J-E-J-S/LPA-hardware/README.md

**Work in Progress**

**96 Well Light Plate Apparatus (LPA)**
==============================================

* incorporate cooling solution 
* reduce LEDs per well 2 -> 1 
* increase wells 24 -> 96
