J-E-J-S/LPA-hardware/Tabor_Docs/specifications/index.html

- Docs »
- Specifications
- View page source

# Specifications¶

Warning

The following specifications describe the LPA v1.0. Changes to later LPA versions are described in the releases section of the github repo.

- Electronics
  - Detailed circuit board photographs
  - Circuit board SD-card reader stage schematic
  - Circuit board microcontroller stage schematic
  - Circuit board LED driver stage schematic
  - Circuit board power stage schematic
- Firmware
  - Introduction
  - States of the Firmware Program
  - TLC5941 Driver module
  - MsTimer Module
  - StatusLeds Module
  - SD Card Reading
  - The config.h File
  - firmware.cpp
- Chassis
  - Detailed photographs of 3D printed LPA parts
  - Photographs of LPA gaskets
- Miscellaneous
  - LPA power connections
  - Photographs of 3D printed auxiliary parts
  - Close-up photograph of LED and LED socket friction fit
  - Photograph and schematic of culture plate used in the LPA

Next Previous

© Copyright 2016, Tabor Lab

Built with Sphinx (http://sphinx-doc.org/) using a theme (https://github.com/rtfd/sphinx_rtd_theme) provided by Read the Docs (https://readthedocs.org).
