J-E-J-S/LPA-hardware/Tabor_Docs/specifications/chassis/specifications_chassis.html

- Docs »
- Specifications »
- Chassis
- View page source

# Chassis¶

## Detailed photographs of 3D printed LPA parts¶

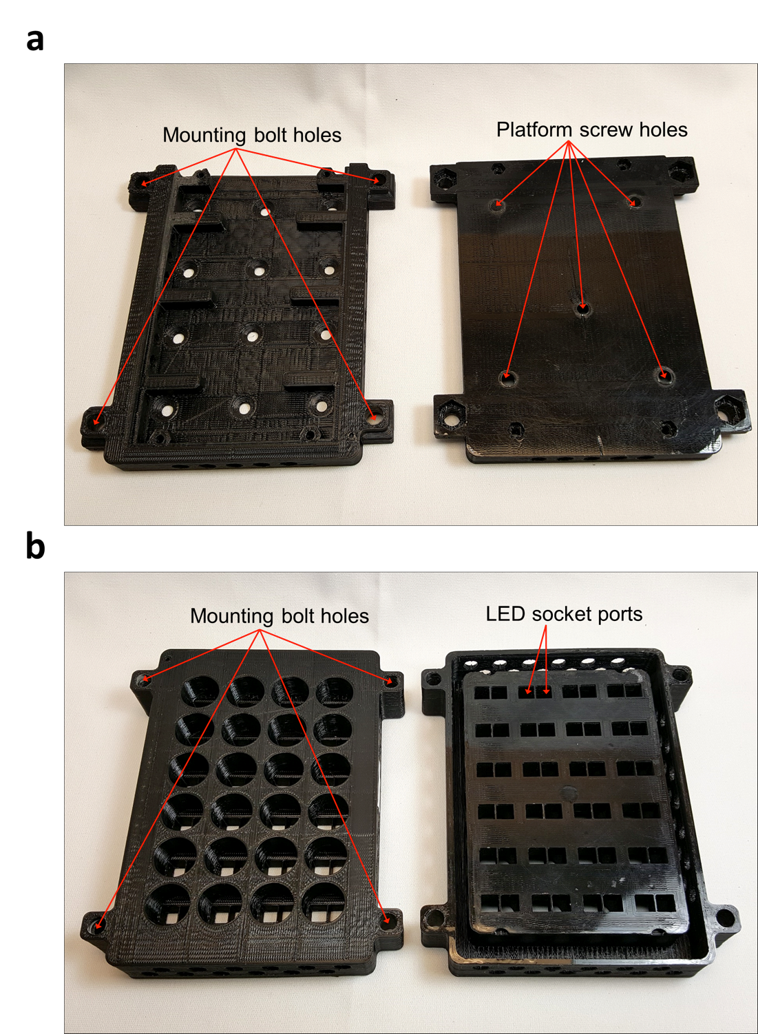
[picture p1: Tabor_Docs/_images/chassis_1.png]


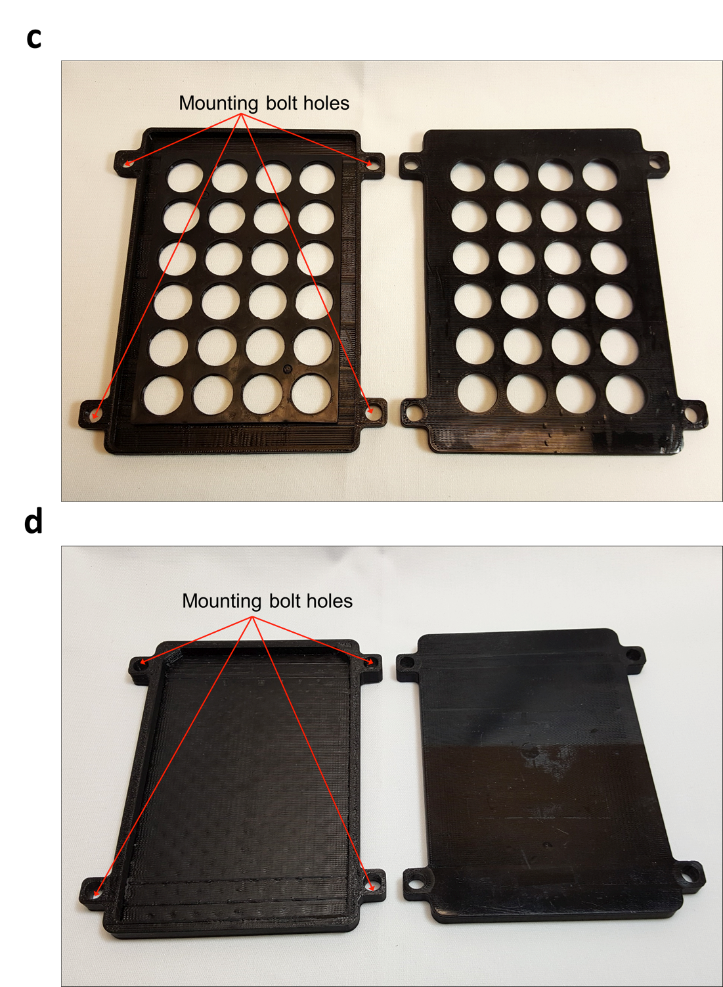
[picture p2: Tabor_Docs/_images/chassis_2.png]


Bottom and top perspectives of 3D printed LPA parts are shown. These include (a) mounting plate, (b) LED spacer, (c) cell culture plate adapter, and (d) device lid. If shaking culture is required, the mounting plate platform holes must be designed for a particular platform. The two mounting plates shown were designed for two different shaking platforms.

## Photographs of LPA gaskets¶



LPA gaskets are laser cut (see Supplementary Method on Laser cutting gaskets) from nitrile sheets (Supplementary Table S6) and prevent light leakage and crosstalk between wells. (a) The (i) circuit board, (ii) LED spacer, and (iii) cell culture plate adapter gaskets are shown. Gasket names are based on the layer they lay atop. Though not necessary, we found it convenient to superglue on the cell culture plate adapter gasket. (b) A plate adapter gasket which has been laser cut with patterns centered with wells of the culture plate.

Next Previous

© Copyright 2016, Tabor Lab

Built with Sphinx (http://sphinx-doc.org/) using a theme (https://github.com/rtfd/sphinx_rtd_theme) provided by Read the Docs (https://readthedocs.org).
