J-E-J-S/LPA-hardware/PCB/output/lpa96_bottom.png

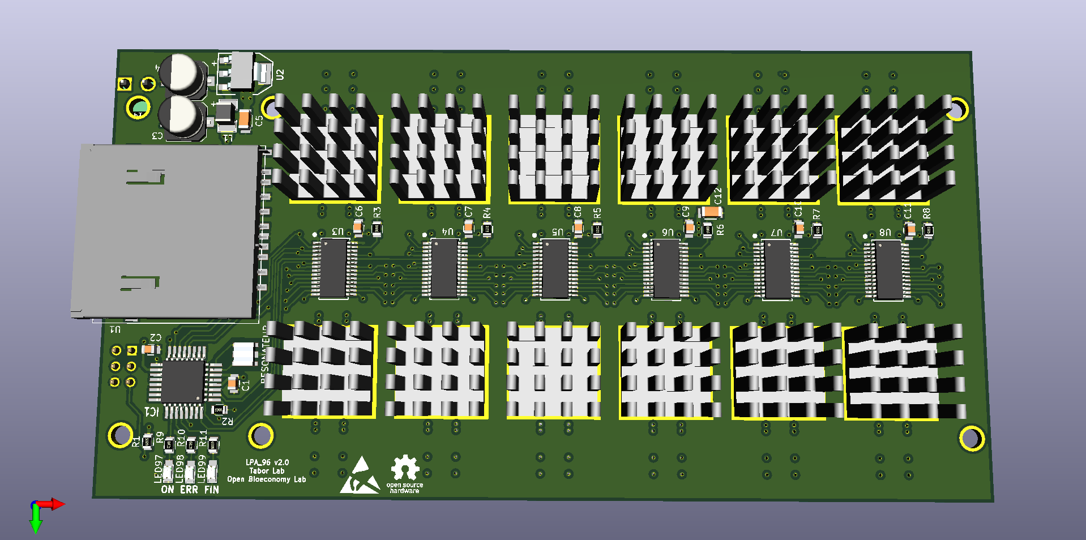
PCB/output/lpa96_bottom.png
