J-E-J-S/LPA-hardware/PCB/output/lpa96_top.png

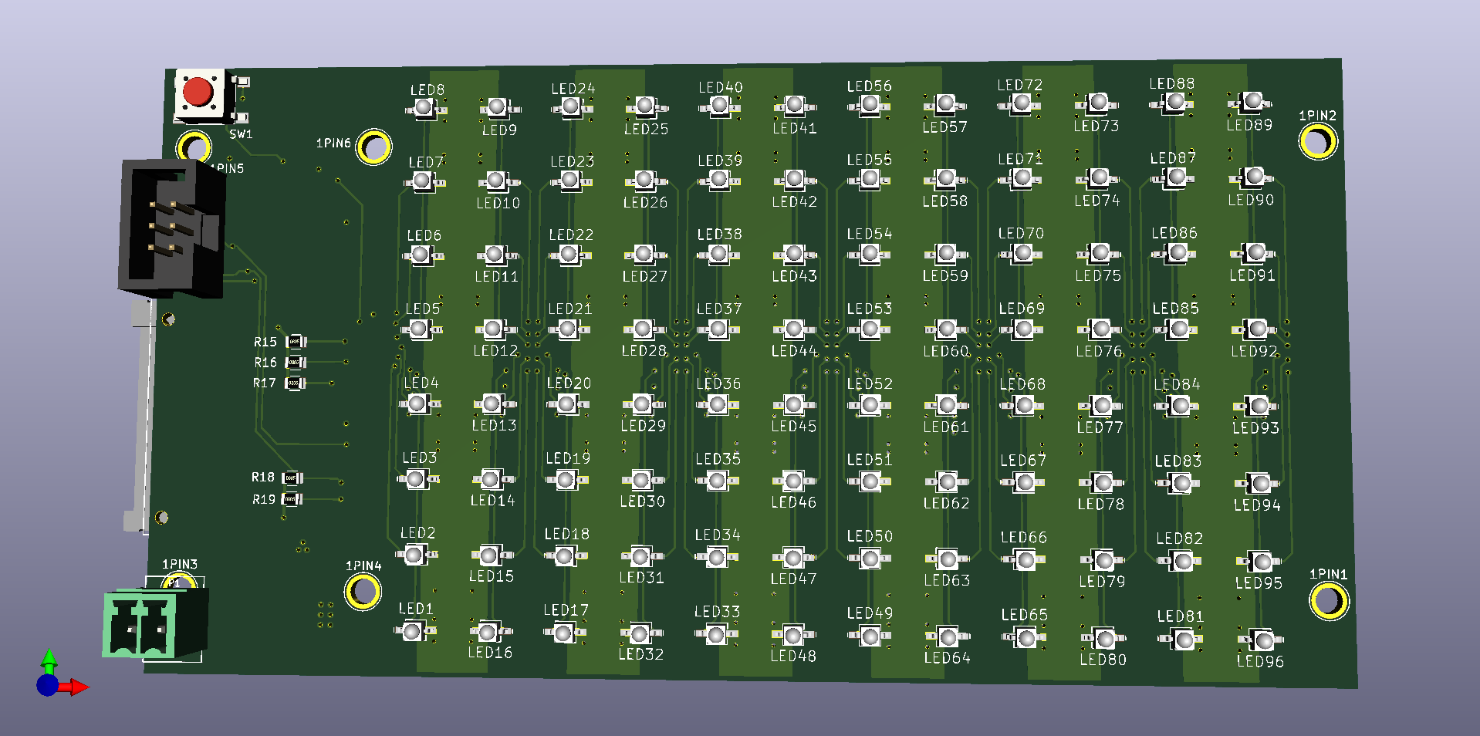
PCB/output/lpa96_top.png
