J-E-J-S/LPA-hardware/Tabor_Docs/_images/firmware_1.png

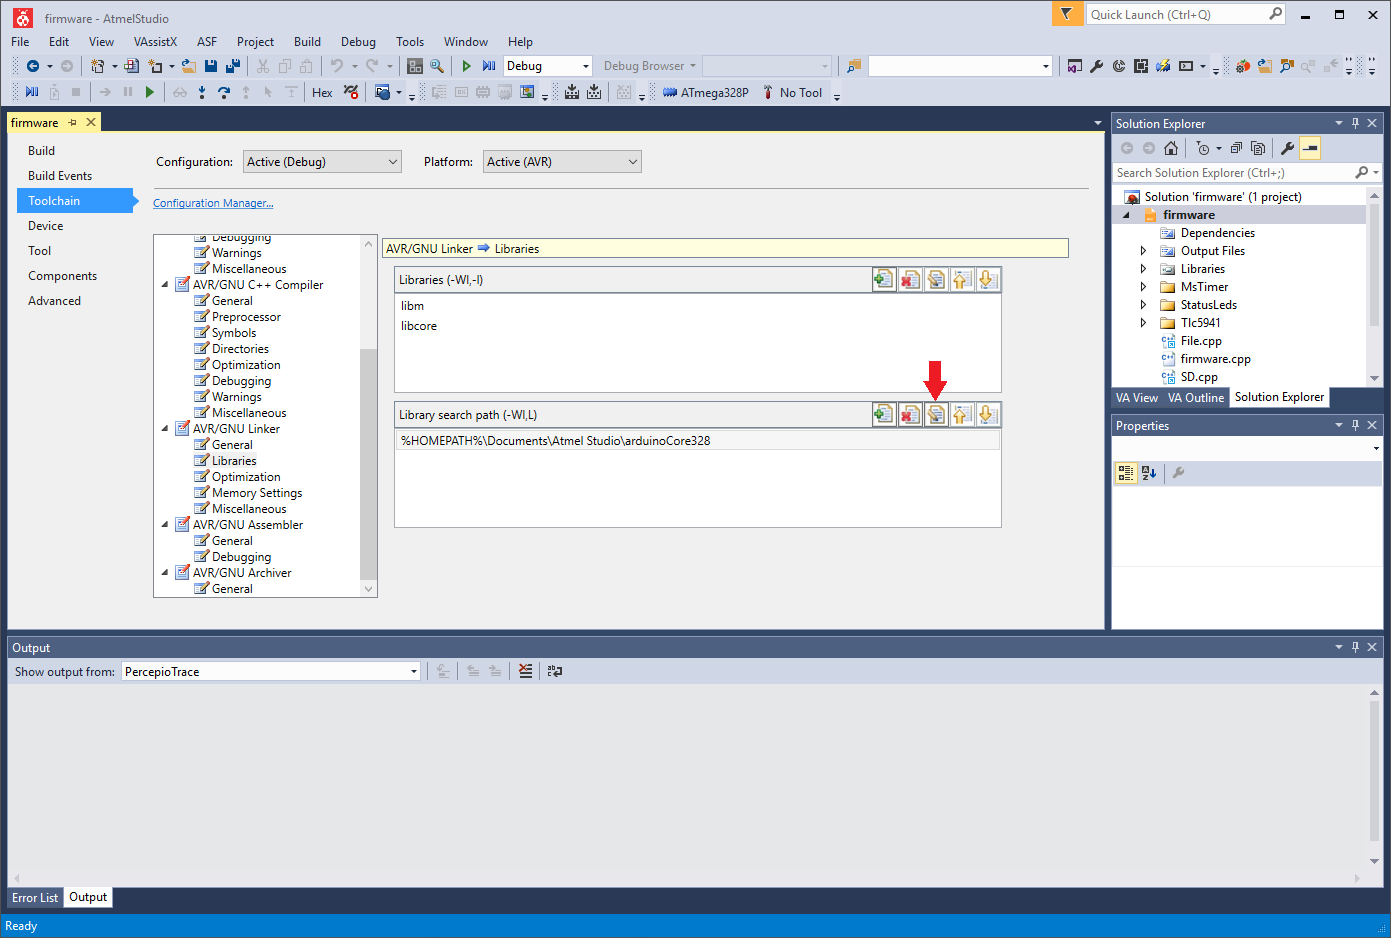
Tabor_Docs/_images/firmware_1.png
