J-E-J-S/LPA-hardware/Tabor_Docs/_images/firmware_2.png

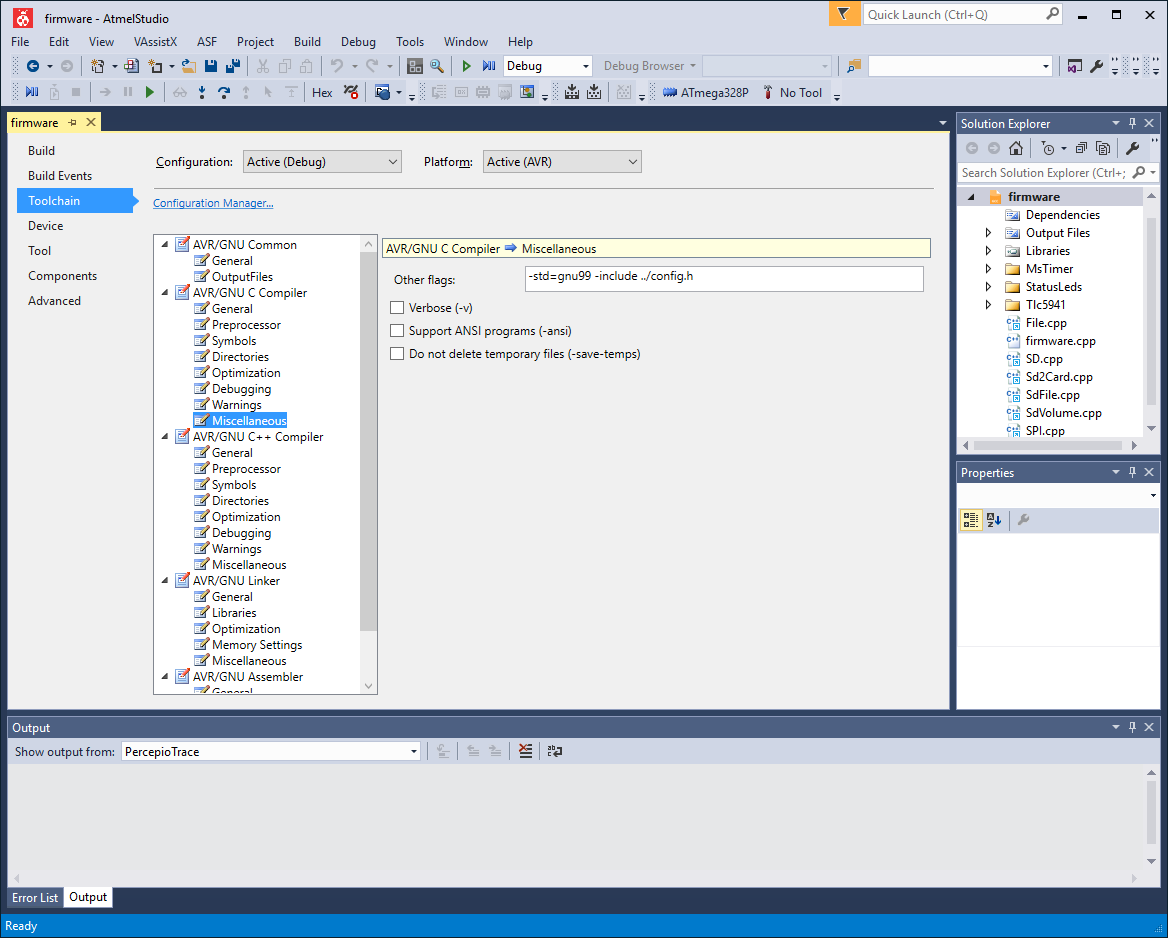
Tabor_Docs/_images/firmware_2.png
