J-E-J-S/LPA-hardware/Tabor_Docs/_images/firmware_4.png

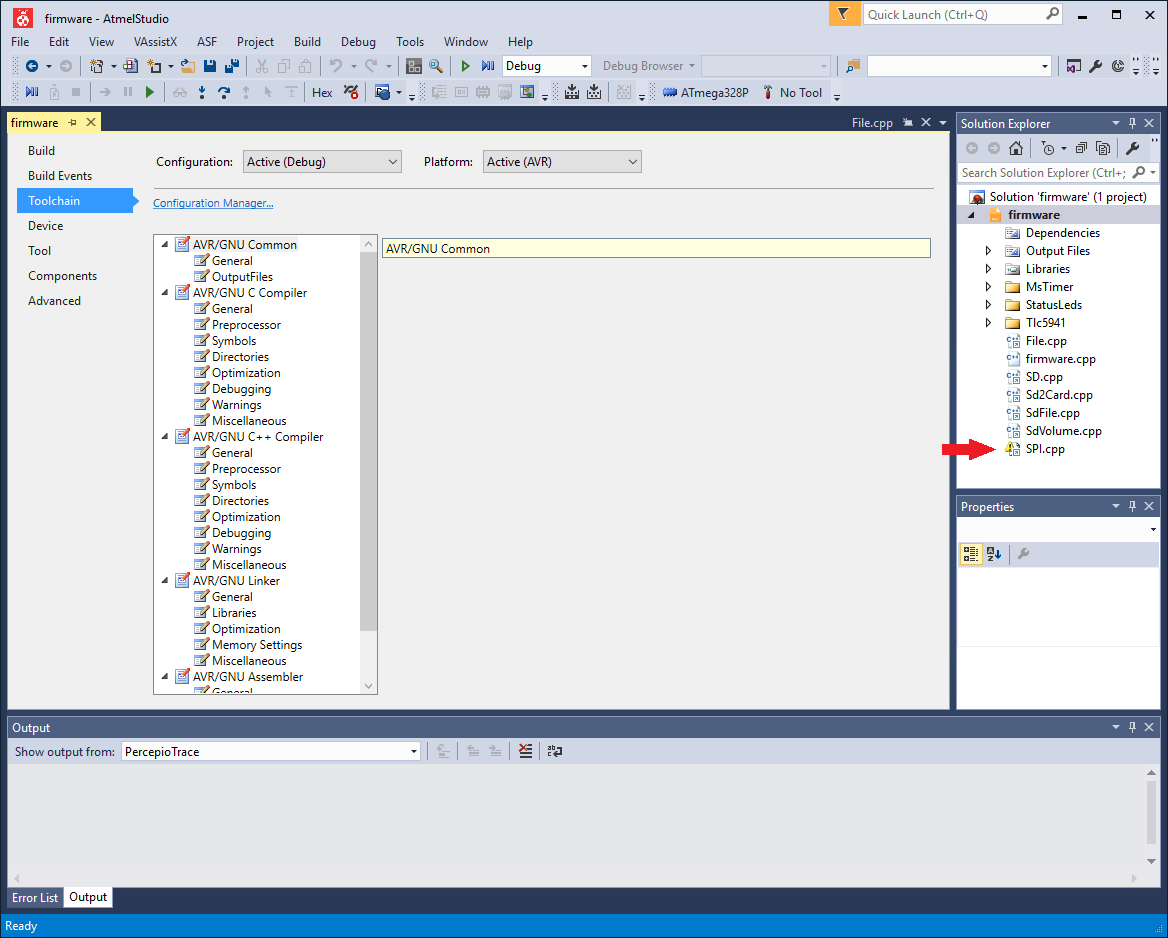
Tabor_Docs/_images/firmware_4.png
