J-E-J-S/LPA-hardware/Tabor_Docs/_images/firmware_6.png

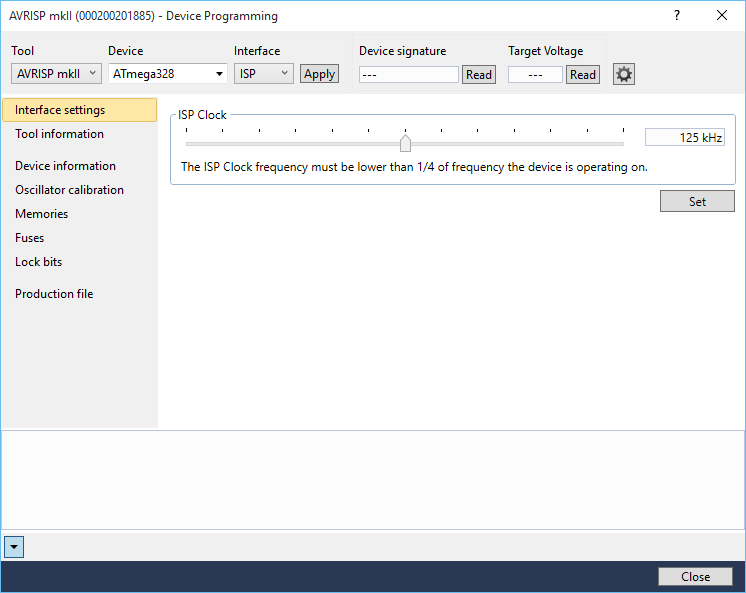
Tabor_Docs/_images/firmware_6.png
