J-E-J-S/LPA-hardware/LPA96_BOM.xlsx

LPA96 v2.0 BOM (incomplete pending source data)
Kevin Bibby 22/08/2019
Item | Qty | Reference(s) | Description | Value | Mfg P/N # | MPN (different) | LibPart | Footprint | Datasheet
1 | 8 | C1, C2, C6, C7, C8, C9, C10, C11 | CAP CER 0.1UF 50V Y5V 0805 | 100nF | CL21F104ZBCNNNC |  | Device:C | Capacitors_SMD:C_0805 | ~
2 | 2 | C3, C4 | 47 uF electrolytic SMD | 47uF | 493-2202-1-ND |  | Device:C | lpa96_footprints:CP_Elec_6.3x5.3 | ~
3 | 2 | C5, C12 | CAP CER 10UF 25V X5R 1206 | 10uF | CL31A106KAHNNNE | C1206C106K3PACTU | Device:C | Capacitors_SMD:C_1206 | ~
4 | 1 | IC1 | IC MCU 8BIT 32KB FLASH 32TQFP | ATMEGA328-A | ATMEGA328-AU |  | lpa96_symbols:ATMEGA328-A | lpa96_footprints:TQFP32_FIXED
5 | 1 | L1 | 10 uH inductor SMD | 10uH | 399-9595-1-ND | CBC3225T100MR | Device:L | lpa96_footprints:L-1210 | ~
6 | 96 | LED1, LED2, LED3, LED4, LED5, LED6, LED7, LED8, LED9, LED10, LED11, LED12, LED13, LED14, LED15, LED16, LED17, LED18, LED19, LED20, LED21, LED22, LED23, LED24, LED25, LED26, LED27, LED28, LED29, LED30, LED31, LED32, LED33, LED34, LED35, LED36, LED37, LED38, LED39, LED40, LED41, LED42, LED43, LED44, LED45, LED46, LED47, LED48, LED49, LED50, LED51, LED52, LED53, LED54, LED55, LED56, LED57, LED58, LED59, LED60, LED61, LED62, LED63, LED64, LED65, LED66, LED67, LED68, LED69, LED70, LED71, LED72, LED73, LED74, LED75, LED76, LED77, LED78, LED79, LED80, LED81, LED82, LED83, LED84, LED85, LED86, LED87, LED88, LED89, LED90, LED91, LED92, LED93, LED94, LED95, LED96 |  | LED_ALT |  |  | Device:LED_ALT | lpa96_footprints:VLDx1232G | ~
7 | 3 | LED97, LED98, LED99 | SMD LED Green / SMD LED Red / SMD LED YELLOW | LED_ALT | 475-1410-1-ND / 475-1415-1-ND / 475-2560-1-ND |  | Device:LED_ALT | LEDs:LED_0805 | ~
8 | 1 | P1 |  | CONN_2 |  |  | lpa96_symbols:CONN_2 | lpa96_footprints:PIN_ARRAY_2X1_3960um
9 | 1 | P2 |  | CONN_3X2 |  |  | lpa96_symbols:CONN_3X2 | lpa96_footprints:pin_array_3x2
10 | 2 | R1, R2 | RES SMD 10K OHM 5% 1/8W 0805 | 10K | ERJ-6GEYJ103V |  | Device:R | Resistors_SMD:R_0805 | ~
11 | 6 | R3, R4, R5, R6, R7, R8 | RES SMD 2.2K OHM 0.5% 1/10W 0805 | 2.2K | RR1220P-222-D |  | Device:R | Resistors_SMD:R_0805 | ~
12 | 3 | R9, R10, R11 | RES SMD 330 OHM 5% 1/8W 0805 | 330 | RC2012J331CS | CRGCQ0805J330R | Device:R | Resistors_SMD:R_0805 | ~
13 | 5 | R15, R16, R17, R18, R19 | 50k resistor (0805) | 50k | P47KACT-ND |  | Device:R | Resistors_SMD:R_0805 | ~
14 | 1 | SW1 | SWITCH TACTILE SPST-NO 0.05A 12V | SW_PUSH | PTS645SK43SMTR92 LFS |  | lpa96_symbols:SW_PUSH | lpa96_footprints:SW_PUSH_SMD | ~
15 | 1 | U1 | CONN SD CARD PUSH-PUSH R/A SMD | SD_CARD | 101-00313-68-02 | 67600-8001 | lpa96_symbols:SD_CARD | lpa96_footprints:SD_CONN
16 | 1 | U2 | LDO Voltage Regulators | LD1117S33 | LD1117S34 |  | lpa96_symbols:LD1117S50 | lpa96_footprints:SOT223 | ~
17 | 6 | U3, U4, U5, U6, U7, U8 | LED Driver IC 16 Output Linear Shift Register 80mA 28-HTSSOP | TLC5941 | TLC5941PWP |  | lpa96_symbols:TLC5941 | lpa96_footprints:TLC5941_PWP_28 | DOCUMENTATION
18 | 1 | Y1 | CRYSTAL 16.0000MHZ 10PF SMD | RESONATEUR | 403C11A16M00000 |  | lpa96_symbols:RESONATEUR | lpa96_footprints:crystal_smd
 |  |  | Breakaway headers (40 pos, 0.100") |  | A34253-40-ND
 |  |  | Molex connector crimp terminal |  | WM18820CT-ND
 |  |  | Molex 2x1 male connector high- power |  | WM18823-ND
 |  |  | Molex 2x1 female connector |  | WM18813-ND
