J-E-J-S/LPA-hardware/3D_files/Assembly/Assembled.stl

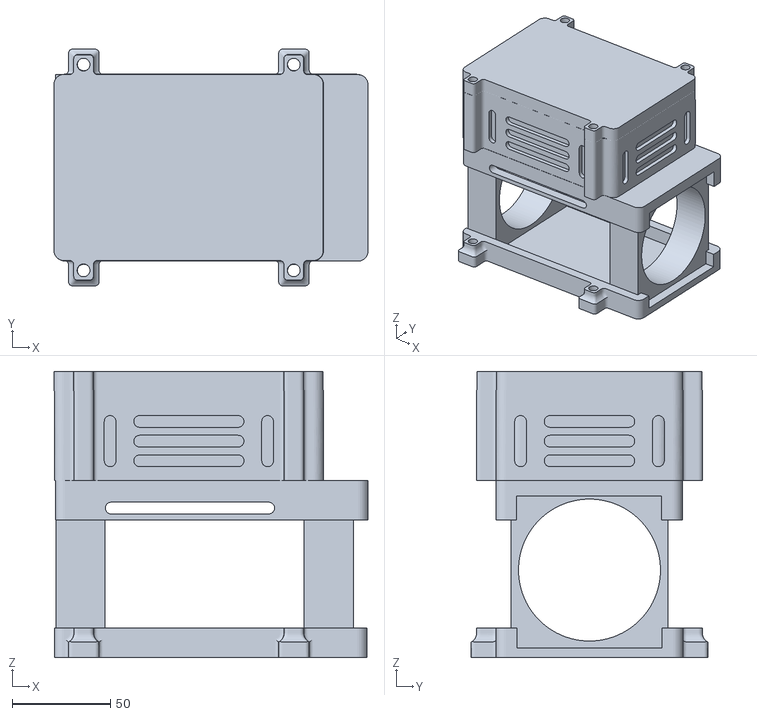
[picture p19: CAD file, 2020-01-30]
3D_files/Assembly/Assembled.stl
159.5 x 120.2 x 145.5
