J-E-J-S/LPA-hardware/3D_files/Assembly/Assembled_Exploded.stl

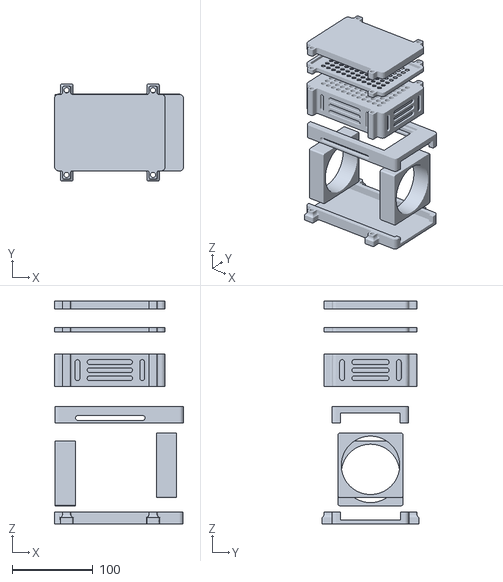
[picture p20: CAD file, 2020-01-30]
3D_files/Assembly/Assembled_Exploded.stl
159.4 x 120.2 x 275.5
