J-E-J-S/LPA-hardware/3D_files/Base_96/Base_96.stl

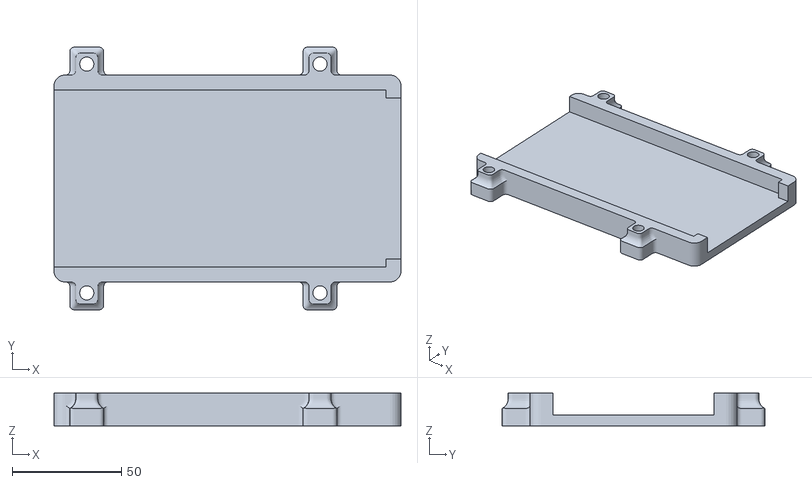
[picture p21: CAD file, 2020-01-29]
3D_files/Base_96/Base_96.stl
158.8 x 120.2 x 15.0
