J-E-J-S/LPA-hardware/3D_files/Gaskets/LED_spacer_gasket/LEDSpacer_Gasket.dxf

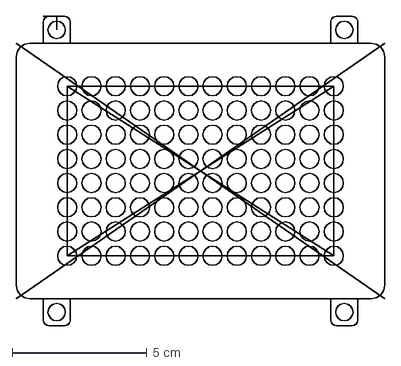
[picture p22: CAD file, 2020-01-29]
3D_files/Gaskets/LED_spacer_gasket/LEDSpacer_Gasket.dxf
13.7 x 11.5 cm
