J-E-J-S/LPA-hardware/3D_files/Gaskets/PCB_gasket/PCB_Gasket.dxf

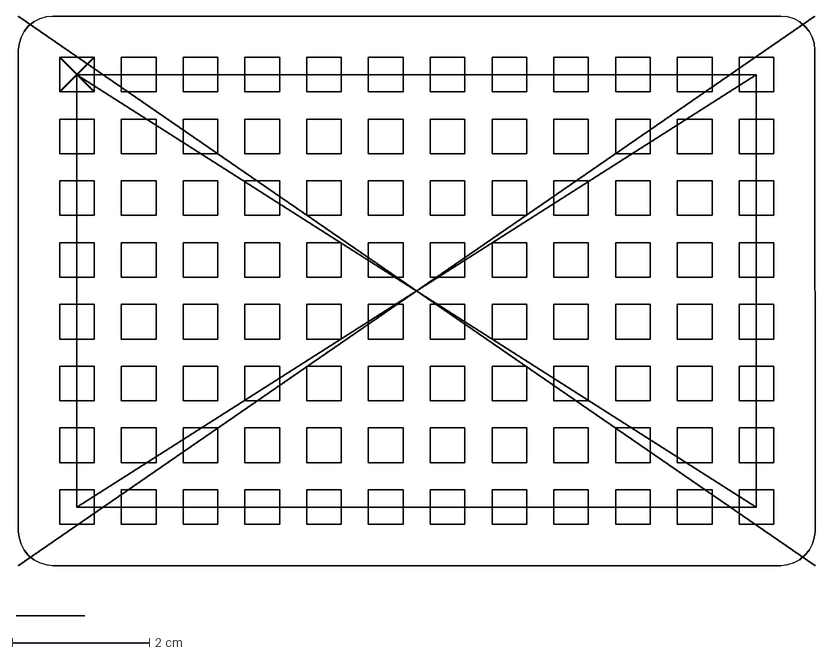
[picture p23: CAD file, 2020-01-29]
3D_files/Gaskets/PCB_gasket/PCB_Gasket.dxf
11.6 x 8.74 cm
