J-E-J-S/LPA-hardware/3D_files/Gaskets/plate_adaptor_gasket/PlateAdaptor_gasket.dxf

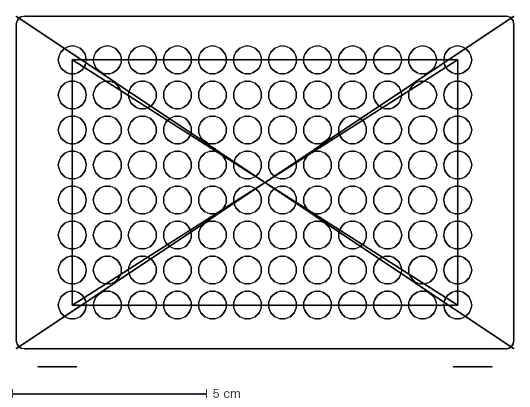
[picture p24: CAD file, 2020-01-29]
3D_files/Gaskets/plate_adaptor_gasket/PlateAdaptor_gasket.dxf
12.8 x 9.01 cm
