J-E-J-S/LPA-hardware/3D_files/LED_Spacer_96/LED_Spacer_96.stl

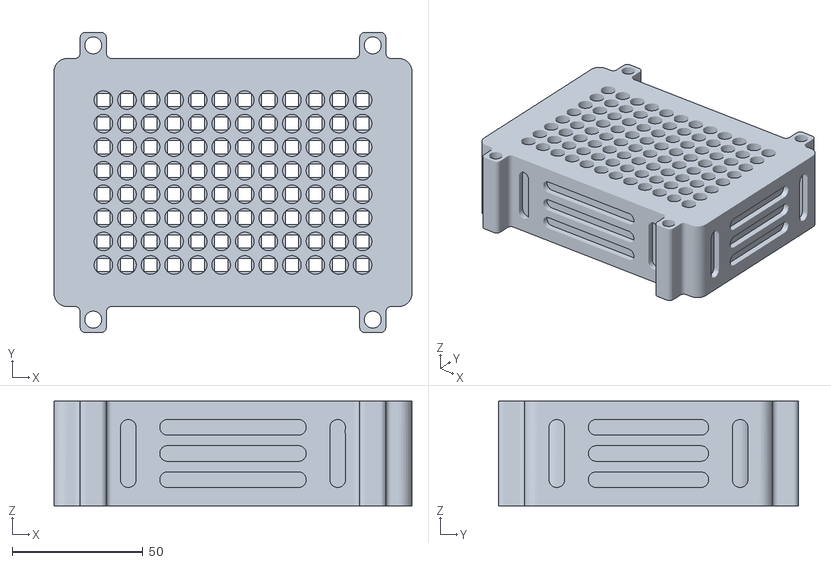
[picture p25: CAD file, 2020-01-29]
3D_files/LED_Spacer_96/LED_Spacer_96.stl
136.8 x 114.7 x 40.0
