J-E-J-S/LPA-hardware/3D_files/Plate_Adaptor_96/Plate_Adaptor_96.stl

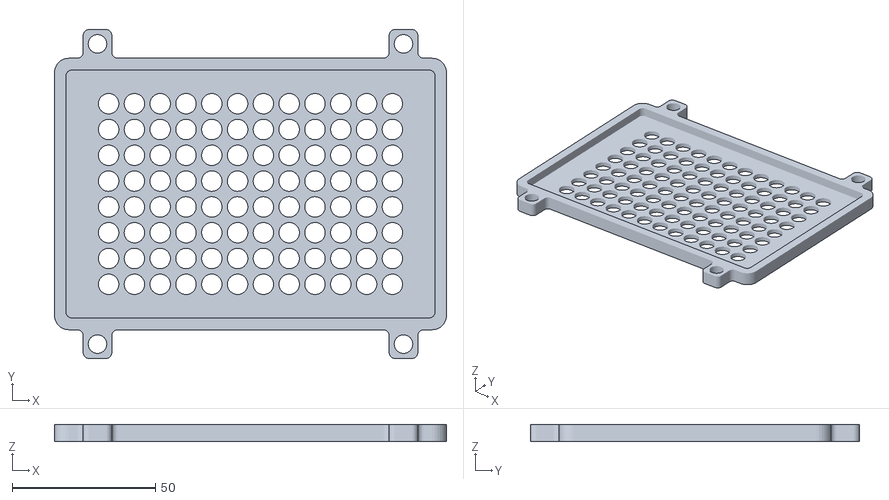
[picture p26: CAD file, 2020-01-29]
3D_files/Plate_Adaptor_96/Plate_Adaptor_96.stl
136.8 x 114.7 x 6.00
