J-E-J-S/LPA-hardware/3D_files/Plate_Lid_96/Plate_Lid_96.stl

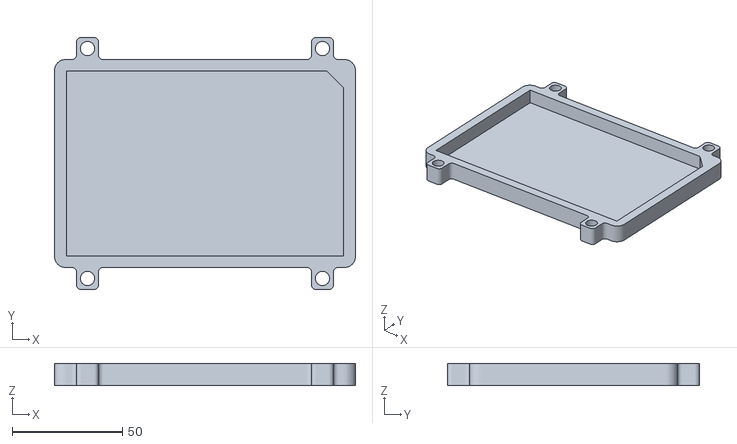
[picture p27: CAD file, 2020-01-29]
3D_files/Plate_Lid_96/Plate_Lid_96.stl
136.8 x 114.5 x 10.0
