J-E-J-S/LPA-hardware/PCB/footprints/3d-models/smd_led_VLDx1535G.step

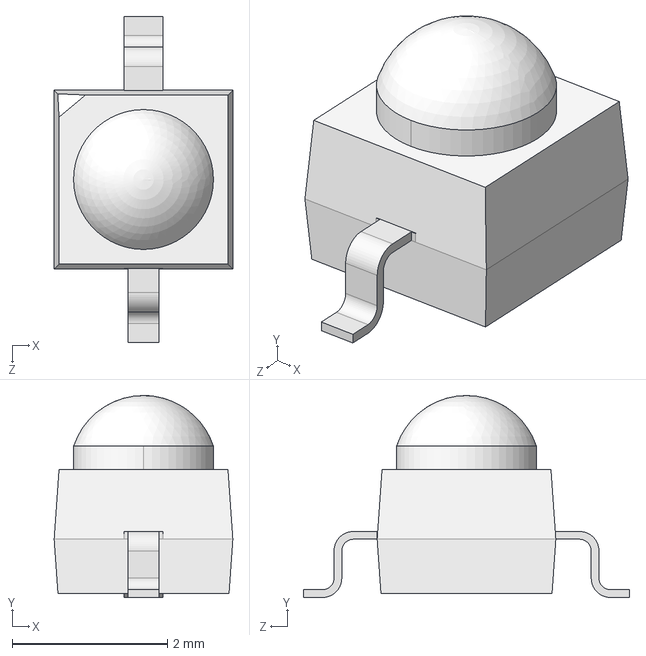
[picture p28: CAD file, 2020-01-29]
PCB/footprints/3d-models/smd_led_VLDx1535G.step
2.30 x 2.60 x 4.20 mm
