J-E-J-S/LPA-hardware/3D_files/Mounting_Plate_96/Mounting_Plate_96.stl

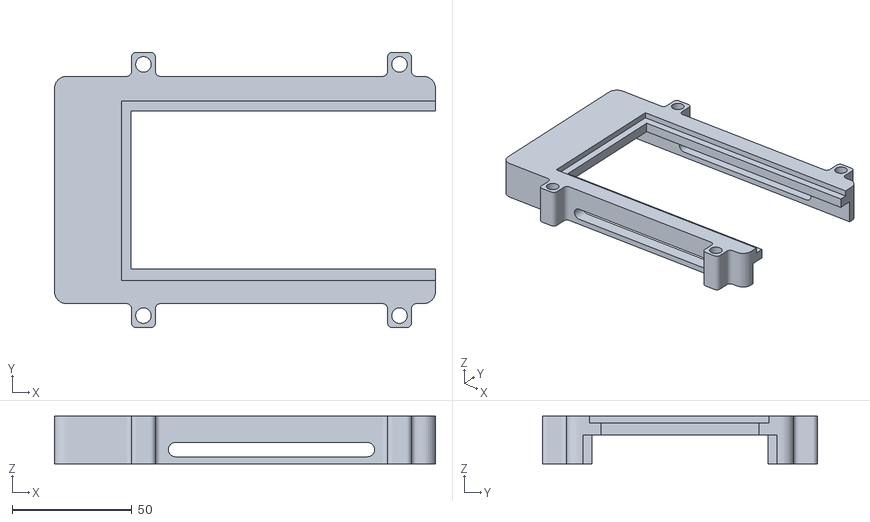
[picture p29: CAD file, 2020-01-29]
3D_files/Mounting_Plate_96/Mounting_Plate_96.stl
158.8 x 114.7 x 20.0
