J-E-J-S/LPA-hardware/PCB/footprints/3d-models/example_resonator.step

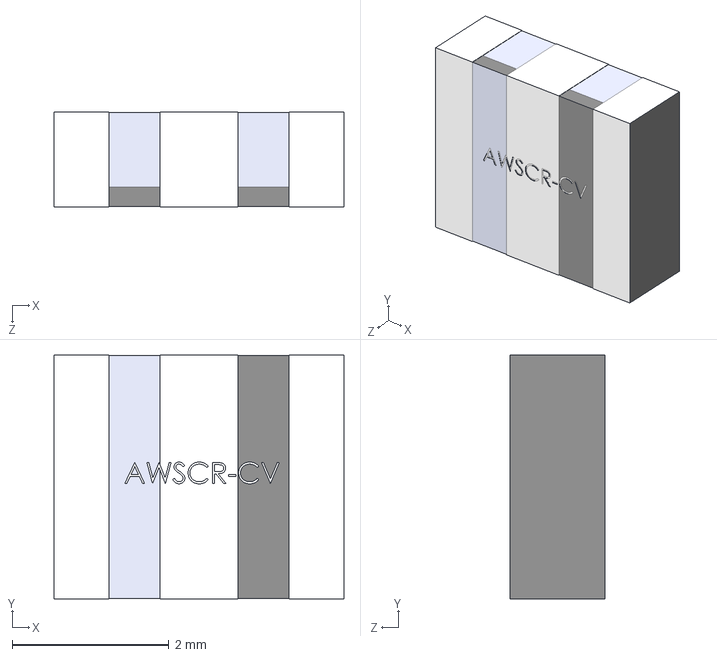
[picture p30: CAD file, 2020-01-29]
PCB/footprints/3d-models/example_resonator.step
3.70 x 3.11 x 1.21 mm
