J-E-J-S/LPA-hardware/PCB/footprints/3d-models/example_heatsink_14x14x14mm.stp

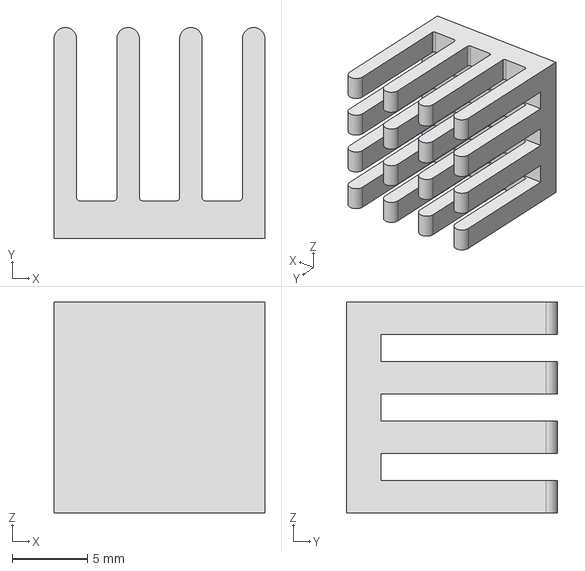
[picture p31: CAD file, 2020-01-29]
PCB/footprints/3d-models/example_heatsink_14x14x14mm.stp
14.0 x 14.0 x 14.0 mm
