J-E-J-S/LPA-hardware/PCB/footprints/3d-models/SD_card_reader_10067847-001RLF.step

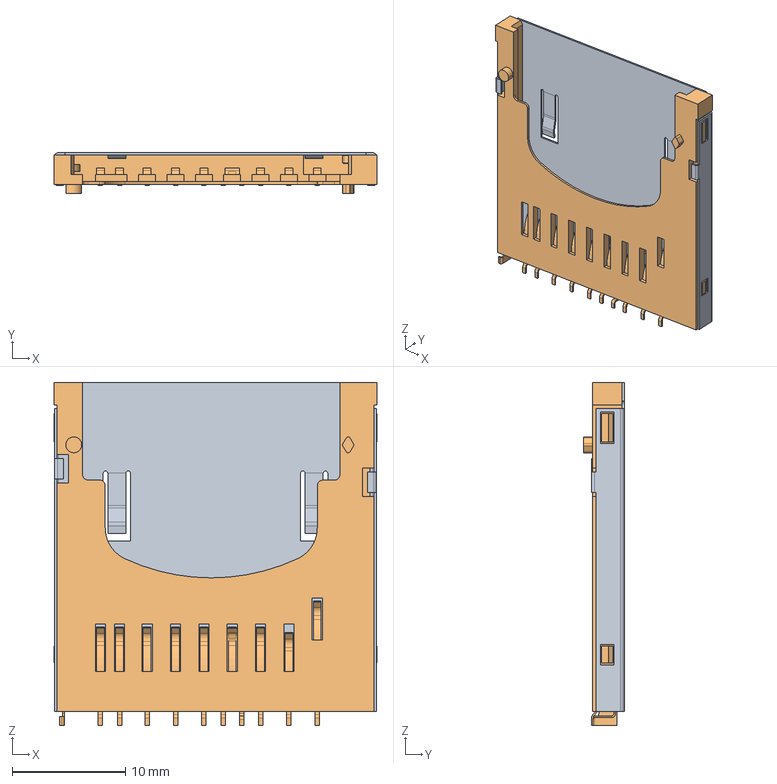
[picture p32: CAD file, 2020-01-29]
PCB/footprints/3d-models/SD_card_reader_10067847-001RLF.step
28.4 x 3.60 x 30.3 mm
PRT0003
PRT0005
