J-E-J-S/LPA-hardware/3D_files/Mounting_Plate_96/Mounting_Plate_96_NoBoltHoles.stl

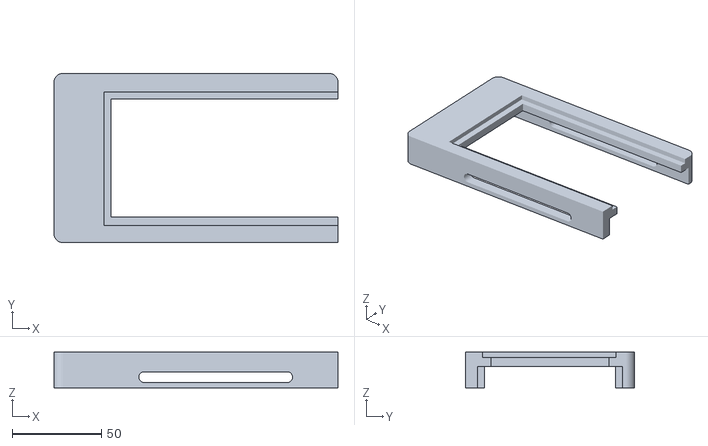
[picture p33: CAD file, 2020-01-29]
3D_files/Mounting_Plate_96/Mounting_Plate_96_NoBoltHoles.stl
158.8 x 94.7 x 20.0
