J-E-J-S/LPA-hardware/(list of files, cad)

Other CAD files:
3D_files/Assembly/Assembled.f3z
3D_files/Assembly/Assembled_Exploded.f3z
3D_files/Base_96/Base_96.f3d
3D_files/Gaskets/LED_spacer_gasket/LEDSpacer_Gasket.f3d
3D_files/Gaskets/PCB_gasket/PCB_Gasket.f3d
3D_files/Gaskets/plate_adaptor_gasket/PlateAdaptor_gasket.f3d
3D_files/LED_Spacer_96/LED_Spacer_96.f3d
3D_files/Mounting_Plate_96/Mounting_Plate_96.f3d
3D_files/Mounting_Plate_96/Mounting_Plate_96_NoBoltHoles.f3d
3D_files/Plate_Adaptor_96/Plate_Adaptor_96.f3d
3D_files/Plate_Lid_96/Plate_Lid_96.f3d
