J-E-J-S/LPA-hardware/Calibration/example/arya_678nm_bot_150802/round1.tif

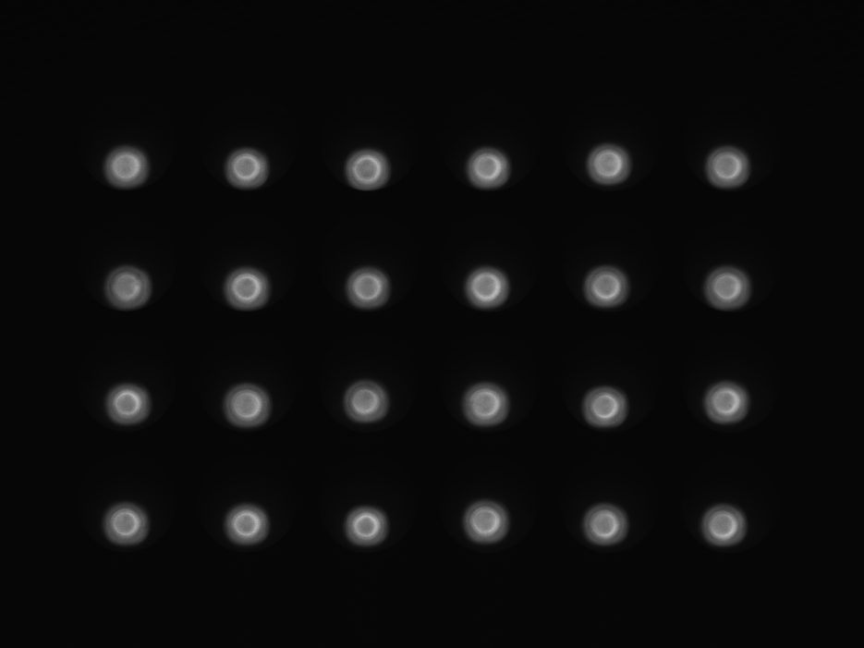
Calibration/example/arya_678nm_bot_150802/round1.tif
