J-E-J-S/LPA-hardware/Calibration/example/arya_678nm_bot_150802/round2.tif

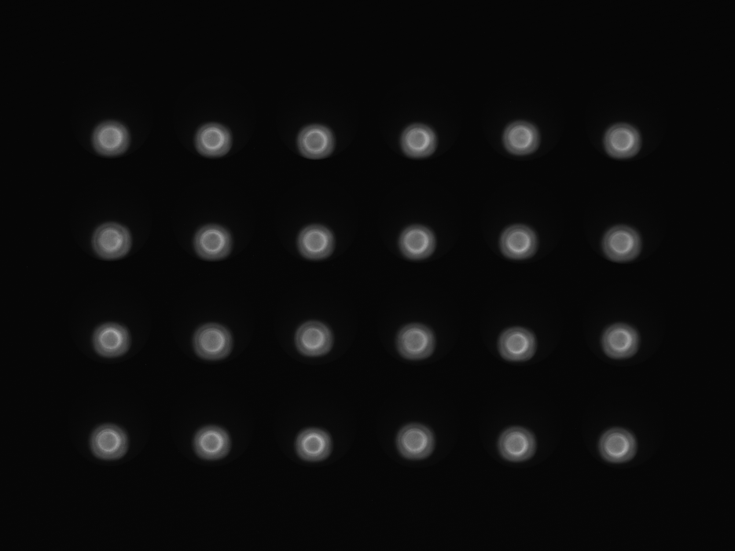
Calibration/example/arya_678nm_bot_150802/round2.tif
