J-E-J-S/LPA-hardware/PCB/output/lpa96_schematic.pdf

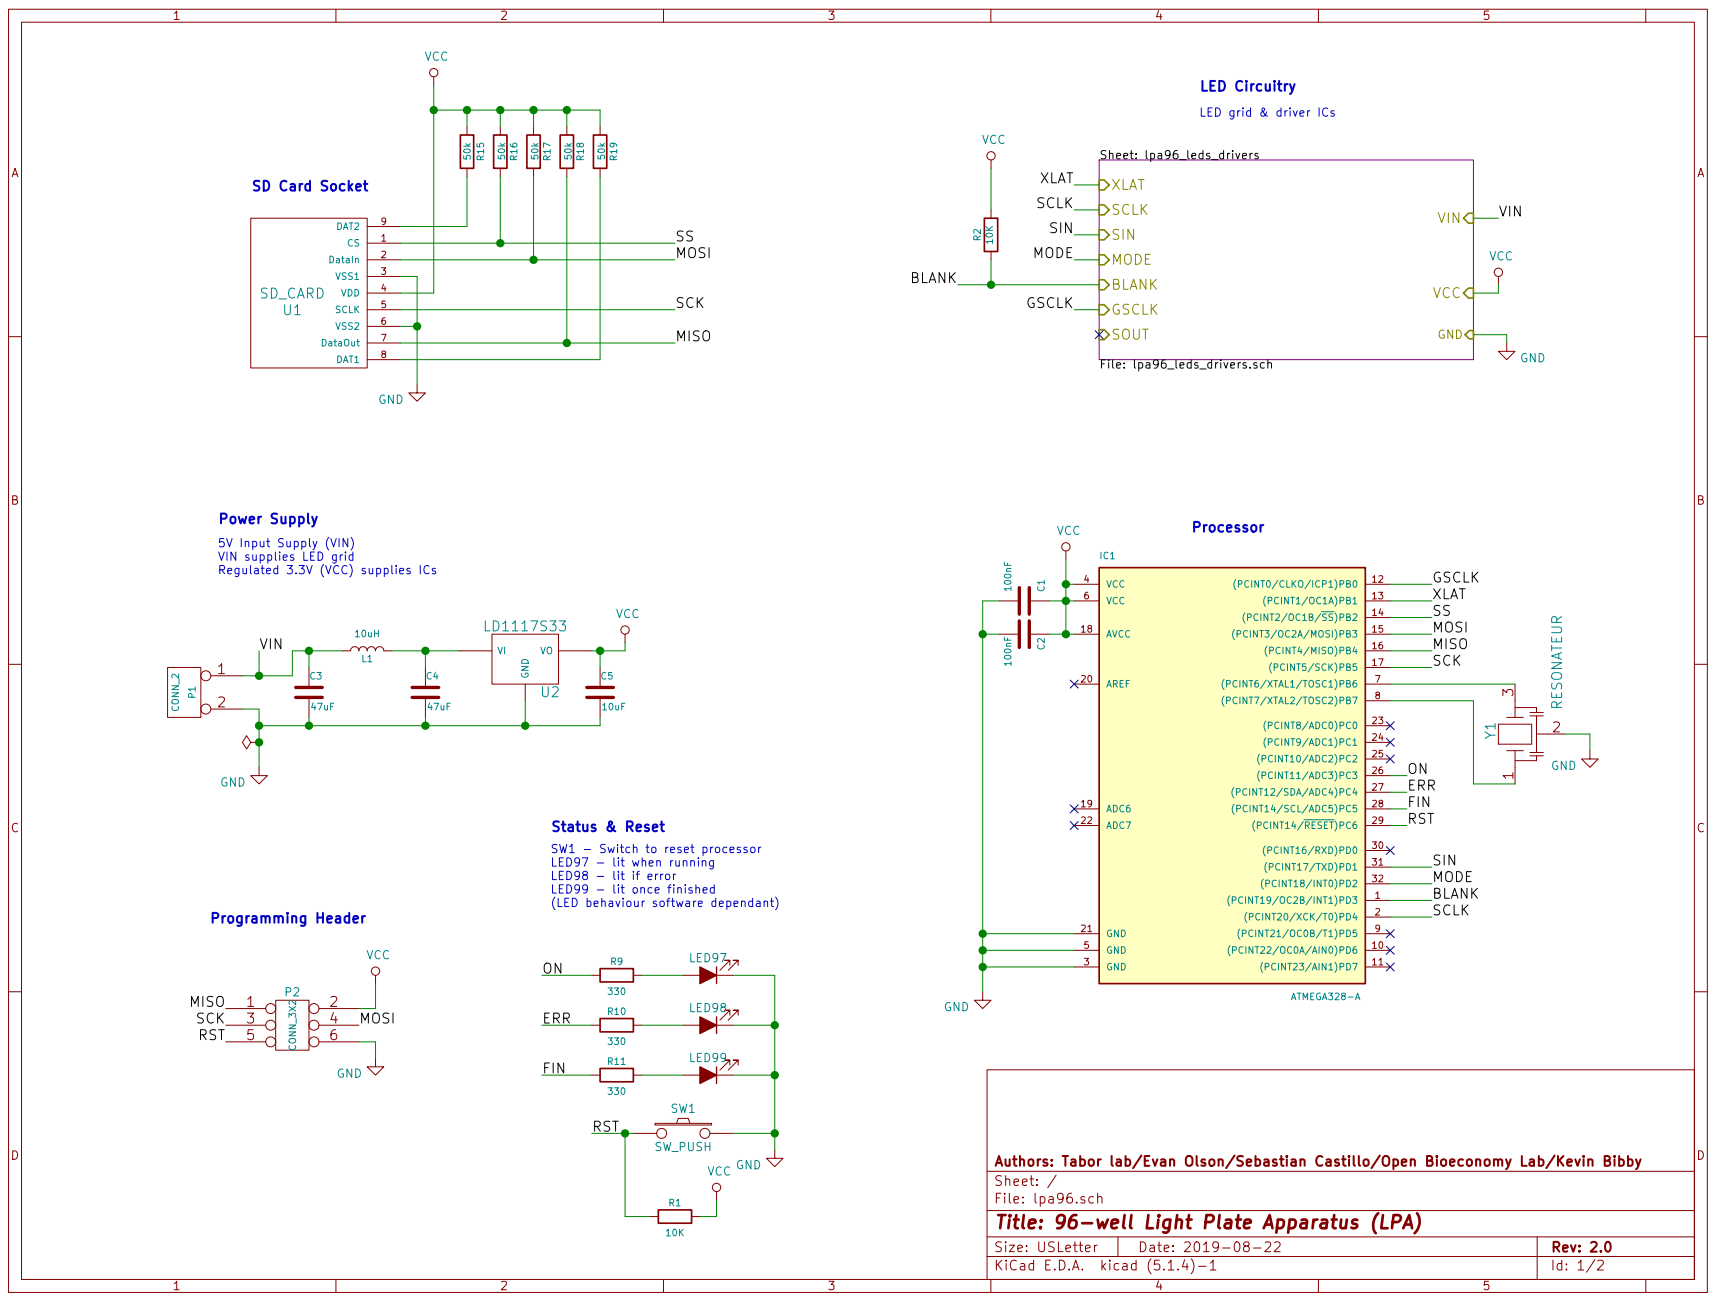
[picture p41: page 1]

LED grid & driver ICs Processor SW1 - Switch to reset processor

File: lpa96_leds_drivers.sch XLAT SCLK

5V Input Supply (VIN)
VIN supplies LED grid

LED97 - lit when running
LED98 - lit if error LED99 - lit once finished

(LED behaviour software dependant)

File: lpa96.sch Sheet: / Authors: Tabor lab/Evan Olson/Sebastian Castillo/Open Bioeconomy Lab/Kevin Bibby

Id: 1/2 Title: 96-well Light Plate Apparatus (LPA)

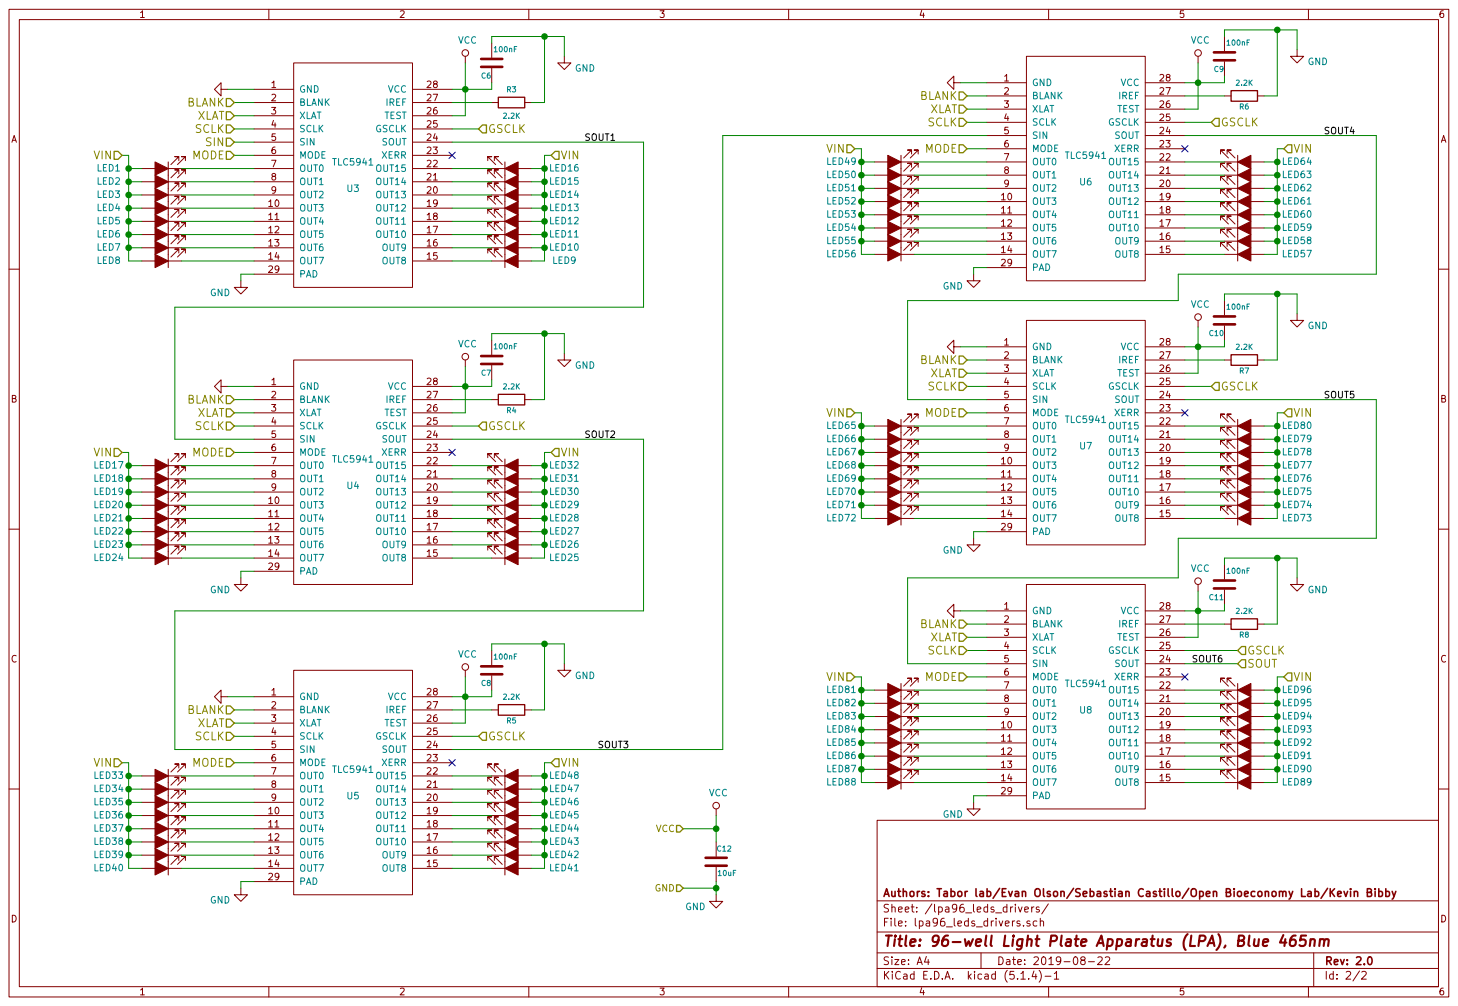
[picture p42: page 2]

Authors: Tabor lab/Evan Olson/Sebastian Castillo/Open Bioeconomy Lab/Kevin Bibby
Sheet: /lpa96_leds_drivers/
File: lpa96_leds_drivers.sch
Id: 2/2 Title: 96-well Light Plate Apparatus (LPA), Blue 465nm
