J-E-J-S/LPA-hardware/PCB/lpa96.kicad_pcb

## KiCad design PCB/lpa96.kicad_pcb (2020-01-29)

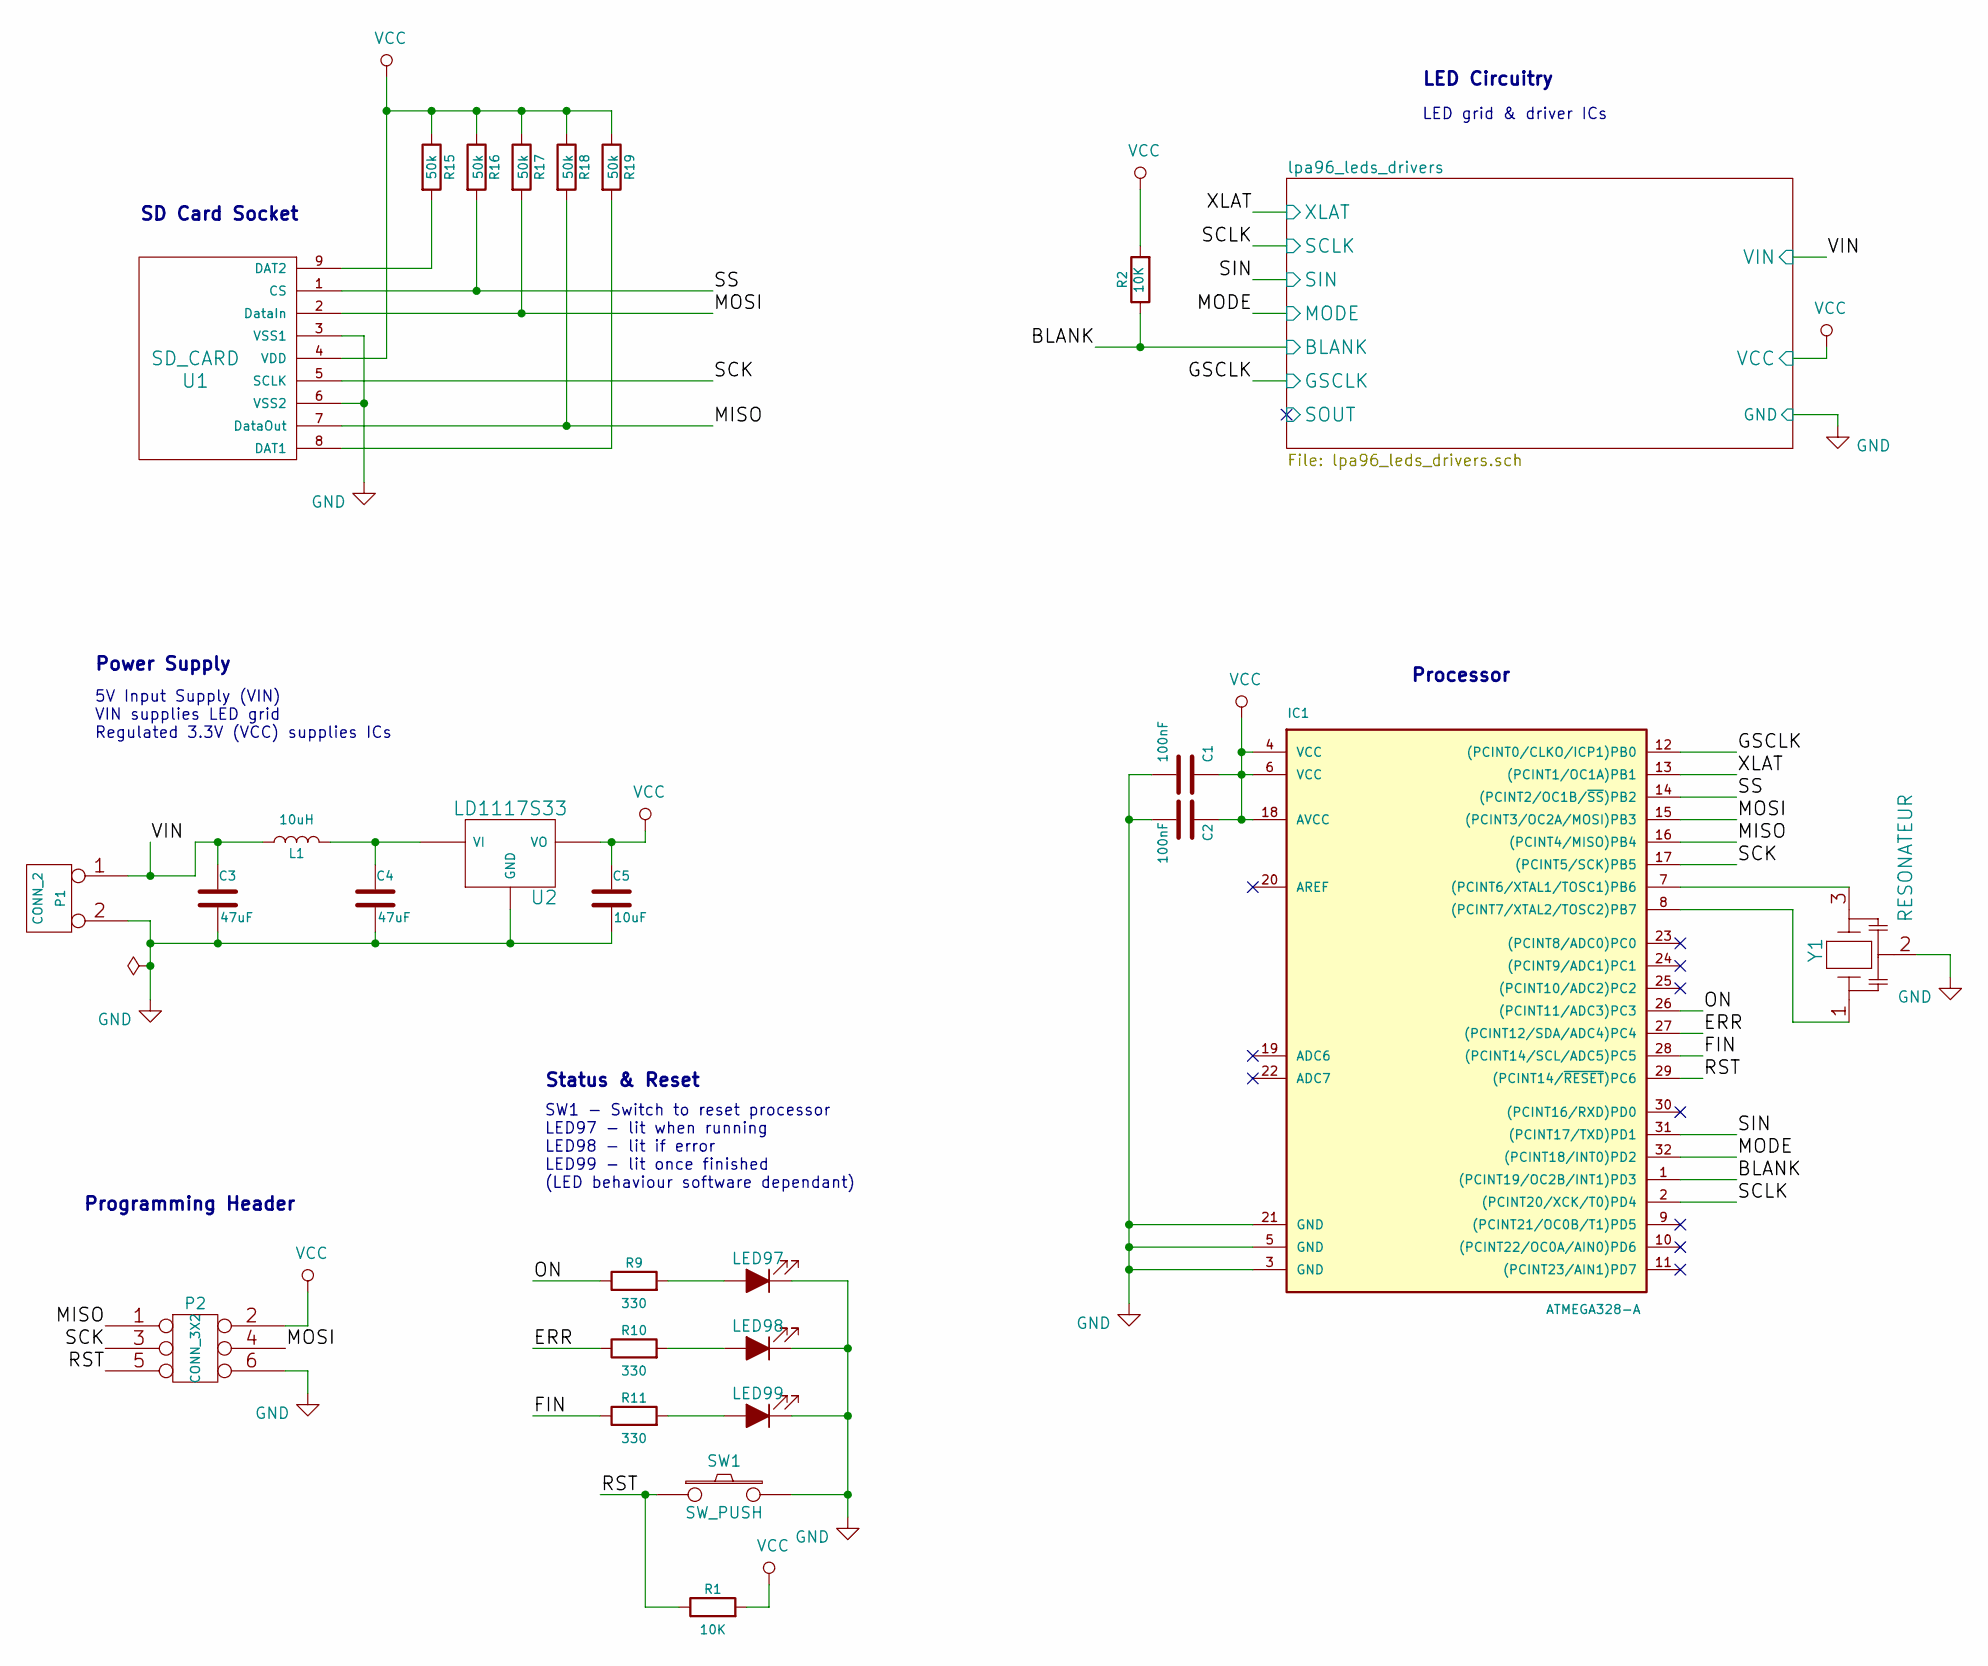
[picture p43: schematic lpa96.sch, 96-well Light Plate Apparatus (LPA)]

Parts:
C1, C2: 100nF; C_0805
C3, C4: 47uF; CP_Elec_6.3x5.3
C5: 10uF; C_1206
IC1: ATMEGA328-A; TQFP32_FIXED
L1: 10uH; L-1210
LED97, LED98, LED99: LED_ALT; LED_0805
P1: CONN_2; PIN_ARRAY_2X1_3960um
P2: CONN_3X2; pin_array_3x2
R1, R2: 10K; R_0805
R9, R10, R11: 330; R_0805
R15, R16, R17, R18, R19: 50k; R_0805
SW1: SW_PUSH; SW_PUSH_SMD
U1: SD_CARD; SD_CONN
U2: LD1117S33; SOT223
Y1: RESONATEUR; crystal_smd

Connections:
/BLANK: IC1.1 ((PCINT19/OC2B/INT1)PD3), R2.1; also elsewhere on the board
/ERR: IC1.27 ((PCINT12/SDA/ADC4)PC4), R10.1
/FIN: IC1.28 ((PCINT14/SCL/ADC5)PC5), R11.1
/GSCLK: IC1.12 ((PCINT0/CLKO/ICP1)PB0); also elsewhere on the board
/MISO: IC1.16 ((PCINT4/MISO)PB4), P2.1, R18.2, U1.7 (DataOut)
/MODE: IC1.32 ((PCINT18/INT0)PD2); also elsewhere on the board
/MOSI: IC1.15 ((PCINT3/OC2A/MOSI)PB3), P2.4, R17.2, U1.2 (DataIn)
/ON: IC1.26 ((PCINT11/ADC3)PC3), R9.1
/RST: IC1.29 ((PCINT14/~RESET~)PC6), P2.5, R1.1, SW1.1
/SCK: IC1.17 ((PCINT5/SCK)PB5), P2.3, U1.5 (SCLK)
/SCLK: IC1.2 ((PCINT20/XCK/T0)PD4); also elsewhere on the board
/SIN: IC1.31 ((PCINT17/TXD)PD1); also elsewhere on the board
/SS: IC1.14 ((PCINT2/OC1B/~SS~)PB2), R16.2, U1.1 (CS)
/VIN: C3.1, L1.1, P1.1; also elsewhere on the board
/XLAT: IC1.13 ((PCINT1/OC1A)PB1); also elsewhere on the board
GND: C1.1, C2.1, C3.2, C4.2, C5.2, IC1.3 (GND), IC1.5 (GND), IC1.21 (GND), LED97.1 (K), LED98.1 (K), LED99.1 (K), P1.2 (PM), P2.6, SW1.2, U1.3 (VSS1), U1.6 (VSS2), U2.1 (GND), Y1.2; also elsewhere on the board
unnamed: C4.1, L1.2, U2.3 (VI)
unnamed: IC1.7 ((PCINT6/XTAL1/TOSC1)PB6), Y1.3
unnamed: IC1.8 ((PCINT7/XTAL2/TOSC2)PB7), Y1.1
unnamed: LED97.2 (A), R9.2
unnamed: LED98.2 (A), R10.2
unnamed: LED99.2 (A), R11.2
unnamed: R15.2, U1.9 (DAT2)
unnamed: R19.2, U1.8 (DAT1)
VCC: C1.2, C2.2, C5.1, IC1.4 (VCC), IC1.6 (VCC), IC1.18 (AVCC), P2.2, R1.2, R2.2, R15.1, R16.1, R17.1, R18.1, R19.1, U1.4 (VDD), U2.2 (VO), U2.4; also elsewhere on the board

Notes on the sheet:
Programming Header
Power Supply
5V Input Supply (VIN) VIN supplies LED grid Regulated 3.3V (VCC) supplies ICs
SD Card Socket
LED Circuitry
LED grid & driver ICs
Processor
SW1 - Switch to reset processor LED97 - lit when running LED98 - lit if error LED99 - lit once finished (LED behaviour software dependant)
Status & Reset

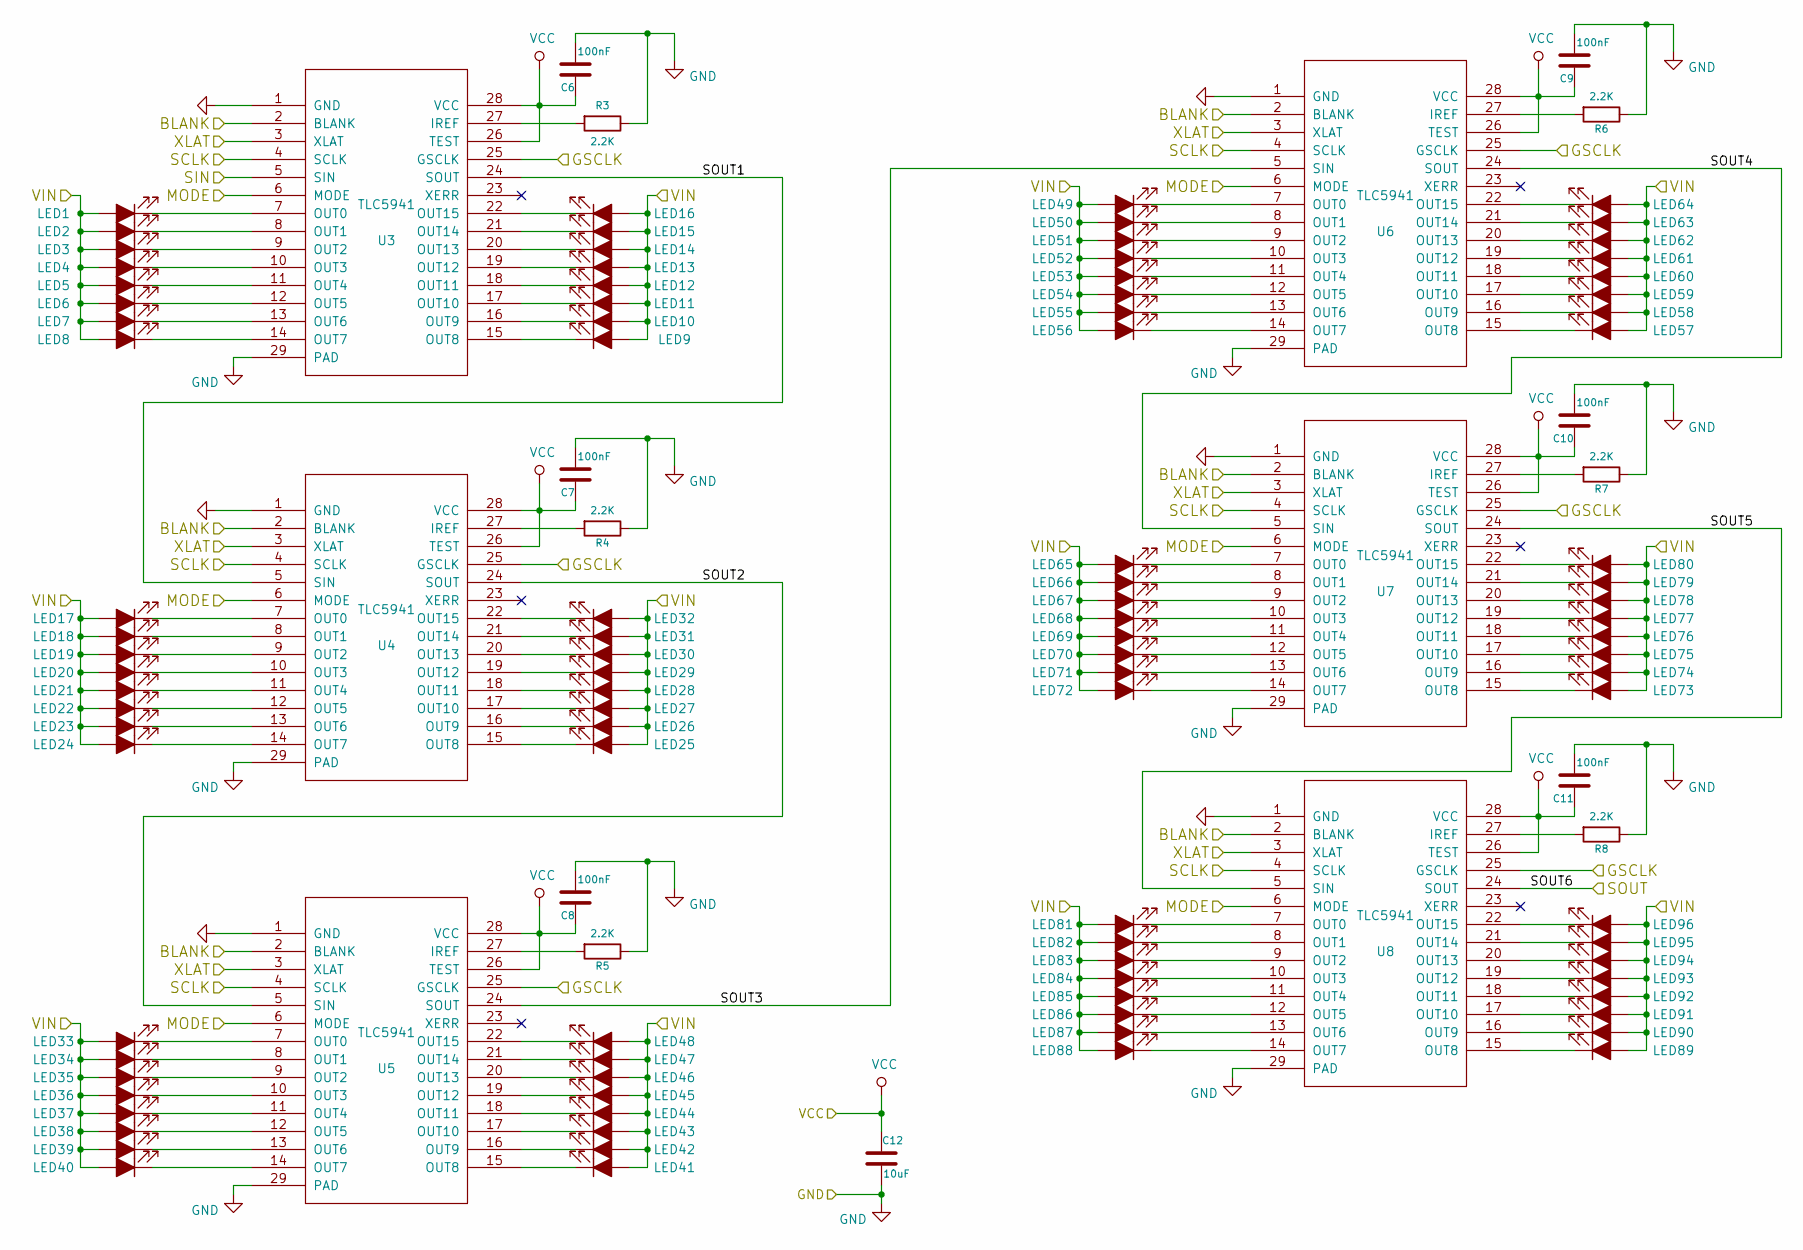
[picture p44: schematic lpa96_leds_drivers.sch, 96-well Light Plate Apparatus (LPA), Blue 465nm]

Parts:
C6, C7, C8, C9, C10, C11: 100nF; C_0805
C12: 10uF; C_1206
LED1, LED2, LED3, LED4, LED5, LED6, LED7, LED8, LED9, LED10, LED11, LED12, LED13, LED14, LED15, LED16, LED17, LED18, LED19, LED20, LED21, LED22, LED23, LED24, LED25, LED26, LED27, LED28, LED29, LED30, LED31, LED32, LED33, LED34, LED35, LED36, LED37, LED38, LED39, LED40, LED41, LED42, LED43, LED44, LED45, LED46, LED47, LED48, LED49, LED50, LED51, LED52, LED53, LED54, LED55, LED56, LED57, LED58, LED59, LED60, LED61, LED62, LED63, LED64, LED65, LED66, LED67, LED68, LED69, LED70, LED71, LED72, LED73, LED74, LED75, LED76, LED77, LED78, LED79, LED80, LED81, LED82, LED83, LED84, LED85, LED86, LED87, LED88, LED89, LED90, LED91, LED92, LED93, LED94, LED95, LED96: LED_ALT; VLDx1232G
R3, R4, R5, R6, R7, R8: 2.2K; R_0805
U3, U4, U5, U6, U7, U8: TLC5941; TLC5941_PWP_28

Connections:
/BLANK: U3.2 (BLANK), U4.2 (BLANK), U5.2 (BLANK), U6.2 (BLANK), U7.2 (BLANK), U8.2 (BLANK); also elsewhere on the board
/GSCLK: U3.25 (GSCLK), U4.25 (GSCLK), U5.25 (GSCLK), U6.25 (GSCLK), U7.25 (GSCLK), U8.25 (GSCLK); also elsewhere on the board
/MODE: U3.6 (MODE), U4.6 (MODE), U5.6 (MODE), U6.6 (MODE), U7.6 (MODE), U8.6 (MODE); also elsewhere on the board
/SCLK: U3.4 (SCLK), U4.4 (SCLK), U5.4 (SCLK), U6.4 (SCLK), U7.4 (SCLK), U8.4 (SCLK); also elsewhere on the board
/SIN: U3.5 (SIN); also elsewhere on the board
/VIN: LED1.2 (A), LED2.2 (A), LED3.2 (A), LED4.2 (A), LED5.2 (A), LED6.2 (A), LED7.2 (A), LED8.2 (A), LED9.2 (A), LED10.2 (A), LED11.2 (A), LED12.2 (A), LED13.2 (A), LED14.2 (A), LED15.2 (A), LED16.2 (A), LED17.2 (A), LED18.2 (A), LED19.2 (A), LED20.2 (A), LED21.2 (A), LED22.2 (A), LED23.2 (A), LED24.2 (A), LED25.2 (A), LED26.2 (A), LED27.2 (A), LED28.2 (A), LED29.2 (A), LED30.2 (A), LED31.2 (A), LED32.2 (A), LED33.2 (A), LED34.2 (A), LED35.2 (A), LED36.2 (A), LED37.2 (A), LED38.2 (A), LED39.2 (A), LED40.2 (A), LED41.2 (A), LED42.2 (A), LED43.2 (A), LED44.2 (A), LED45.2 (A), LED46.2 (A), LED47.2 (A), LED48.2 (A), LED49.2 (A), LED50.2 (A), LED51.2 (A), LED52.2 (A), LED53.2 (A), LED54.2 (A), LED55.2 (A), LED56.2 (A), LED57.2 (A), LED58.2 (A), LED59.2 (A), LED60.2 (A), LED61.2 (A), LED62.2 (A), LED63.2 (A), LED64.2 (A), LED65.2 (A), LED66.2 (A), LED67.2 (A), LED68.2 (A), LED69.2 (A), LED70.2 (A), LED71.2 (A), LED72.2 (A), LED73.2 (A), LED74.2 (A), LED75.2 (A), LED76.2 (A), LED77.2 (A), LED78.2 (A), LED79.2 (A), LED80.2 (A), LED81.2 (A), LED82.2 (A), LED83.2 (A), LED84.2 (A), LED85.2 (A), LED86.2 (A), LED87.2 (A), LED88.2 (A), LED89.2 (A), LED90.2 (A), LED91.2 (A), LED92.2 (A), LED93.2 (A), LED94.2 (A), LED95.2 (A), LED96.2 (A); also elsewhere on the board
/XLAT: U3.3 (XLAT), U4.3 (XLAT), U5.3 (XLAT), U6.3 (XLAT), U7.3 (XLAT), U8.3 (XLAT); also elsewhere on the board
/lpa96_leds_drivers/SOUT: U8.24 (SOUT)
/lpa96_leds_drivers/SOUT1: U3.24 (SOUT), U4.5 (SIN)
/lpa96_leds_drivers/SOUT2: U4.24 (SOUT), U5.5 (SIN)
/lpa96_leds_drivers/SOUT3: U5.24 (SOUT), U6.5 (SIN)
/lpa96_leds_drivers/SOUT4: U6.24 (SOUT), U7.5 (SIN)
/lpa96_leds_drivers/SOUT5: U7.24 (SOUT), U8.5 (SIN)
GND: C6.2, C7.2, C8.2, C9.2, C10.2, C11.2, C12.2, R3.1, R4.1, R5.1, R6.1, R7.1, R8.1, U3.1 (GND), U3.29 (PAD), U4.1 (GND), U4.29 (PAD), U5.1 (GND), U5.29 (PAD), U6.1 (GND), U6.29 (PAD), U7.1 (GND), U7.29 (PAD), U8.1 (GND), U8.29 (PAD); also elsewhere on the board
unnamed: LED1.1 (K), U3.7 (OUT0)
unnamed: LED2.1 (K), U3.8 (OUT1)
unnamed: LED3.1 (K), U3.9 (OUT2)
unnamed: LED4.1 (K), U3.10 (OUT3)
unnamed: LED5.1 (K), U3.11 (OUT4)
unnamed: LED6.1 (K), U3.12 (OUT5)
unnamed: LED7.1 (K), U3.13 (OUT6)
unnamed: LED8.1 (K), U3.14 (OUT7)
unnamed: LED9.1 (K), U3.15 (OUT8)
unnamed: LED10.1 (K), U3.16 (OUT9)
unnamed: LED11.1 (K), U3.17 (OUT10)
unnamed: LED12.1 (K), U3.18 (OUT11)
unnamed: LED13.1 (K), U3.19 (OUT12)
unnamed: LED14.1 (K), U3.20 (OUT13)
unnamed: LED15.1 (K), U3.21 (OUT14)
unnamed: LED16.1 (K), U3.22 (OUT15)
unnamed: LED17.1 (K), U4.7 (OUT0)
unnamed: LED18.1 (K), U4.8 (OUT1)
unnamed: LED19.1 (K), U4.9 (OUT2)
unnamed: LED20.1 (K), U4.10 (OUT3)
unnamed: LED21.1 (K), U4.11 (OUT4)
unnamed: LED22.1 (K), U4.12 (OUT5)
unnamed: LED23.1 (K), U4.13 (OUT6)
unnamed: LED24.1 (K), U4.14 (OUT7)
unnamed: LED25.1 (K), U4.15 (OUT8)
unnamed: LED26.1 (K), U4.16 (OUT9)
unnamed: LED27.1 (K), U4.17 (OUT10)
unnamed: LED28.1 (K), U4.18 (OUT11)
unnamed: LED29.1 (K), U4.19 (OUT12)
unnamed: LED30.1 (K), U4.20 (OUT13)
unnamed: LED31.1 (K), U4.21 (OUT14)
unnamed: LED32.1 (K), U4.22 (OUT15)
unnamed: LED33.1 (K), U5.7 (OUT0)
unnamed: LED34.1 (K), U5.8 (OUT1)
unnamed: LED35.1 (K), U5.9 (OUT2)
unnamed: LED36.1 (K), U5.10 (OUT3)
unnamed: LED37.1 (K), U5.11 (OUT4)
unnamed: LED38.1 (K), U5.12 (OUT5)
unnamed: LED39.1 (K), U5.13 (OUT6)
unnamed: LED40.1 (K), U5.14 (OUT7)
unnamed: LED41.1 (K), U5.15 (OUT8)
unnamed: LED42.1 (K), U5.16 (OUT9)
unnamed: LED43.1 (K), U5.17 (OUT10)
unnamed: LED44.1 (K), U5.18 (OUT11)
unnamed: LED45.1 (K), U5.19 (OUT12)
unnamed: LED46.1 (K), U5.20 (OUT13)
unnamed: LED47.1 (K), U5.21 (OUT14)
unnamed: LED48.1 (K), U5.22 (OUT15)
unnamed: LED49.1 (K), U6.7 (OUT0)
unnamed: LED50.1 (K), U6.8 (OUT1)
unnamed: LED51.1 (K), U6.9 (OUT2)
unnamed: LED52.1 (K), U6.10 (OUT3)
unnamed: LED53.1 (K), U6.11 (OUT4)
unnamed: LED54.1 (K), U6.12 (OUT5)
unnamed: LED55.1 (K), U6.13 (OUT6)
unnamed: LED56.1 (K), U6.14 (OUT7)
unnamed: LED57.1 (K), U6.15 (OUT8)
unnamed: LED58.1 (K), U6.16 (OUT9)
unnamed: LED59.1 (K), U6.17 (OUT10)
unnamed: LED60.1 (K), U6.18 (OUT11)
unnamed: LED61.1 (K), U6.19 (OUT12)
unnamed: LED62.1 (K), U6.20 (OUT13)
unnamed: LED63.1 (K), U6.21 (OUT14)
unnamed: LED64.1 (K), U6.22 (OUT15)
unnamed: LED65.1 (K), U7.7 (OUT0)
unnamed: LED66.1 (K), U7.8 (OUT1)
unnamed: LED67.1 (K), U7.9 (OUT2)
unnamed: LED68.1 (K), U7.10 (OUT3)
unnamed: LED69.1 (K), U7.11 (OUT4)
unnamed: LED70.1 (K), U7.12 (OUT5)
unnamed: LED71.1 (K), U7.13 (OUT6)
unnamed: LED72.1 (K), U7.14 (OUT7)
unnamed: LED73.1 (K), U7.15 (OUT8)
unnamed: LED74.1 (K), U7.16 (OUT9)
unnamed: LED75.1 (K), U7.17 (OUT10)
unnamed: LED76.1 (K), U7.18 (OUT11)
unnamed: LED77.1 (K), U7.19 (OUT12)
unnamed: LED78.1 (K), U7.20 (OUT13)
unnamed: LED79.1 (K), U7.21 (OUT14)
unnamed: LED80.1 (K), U7.22 (OUT15)
unnamed: LED81.1 (K), U8.7 (OUT0)
unnamed: LED82.1 (K), U8.8 (OUT1)
unnamed: LED83.1 (K), U8.9 (OUT2)
unnamed: LED84.1 (K), U8.10 (OUT3)
unnamed: LED85.1 (K), U8.11 (OUT4)
unnamed: LED86.1 (K), U8.12 (OUT5)
unnamed: LED87.1 (K), U8.13 (OUT6)
unnamed: LED88.1 (K), U8.14 (OUT7)
unnamed: LED89.1 (K), U8.15 (OUT8)
unnamed: LED90.1 (K), U8.16 (OUT9)
unnamed: LED91.1 (K), U8.17 (OUT10)
unnamed: LED92.1 (K), U8.18 (OUT11)
unnamed: LED93.1 (K), U8.19 (OUT12)
unnamed: LED94.1 (K), U8.20 (OUT13)
unnamed: LED95.1 (K), U8.21 (OUT14)
unnamed: LED96.1 (K), U8.22 (OUT15)
unnamed: R3.2, U3.27 (IREF)
unnamed: R4.2, U4.27 (IREF)
unnamed: R5.2, U5.27 (IREF)
unnamed: R6.2, U6.27 (IREF)
unnamed: R7.2, U7.27 (IREF)
unnamed: R8.2, U8.27 (IREF)
VCC: C6.1, C7.1, C8.1, C9.1, C10.1, C11.1, C12.1, U3.26 (TEST), U3.28 (VCC), U4.26 (TEST), U4.28 (VCC), U5.26 (TEST), U5.28 (VCC), U6.26 (TEST), U6.28 (VCC), U7.26 (TEST), U7.28 (VCC), U8.26 (TEST), U8.28 (VCC); also elsewhere on the board

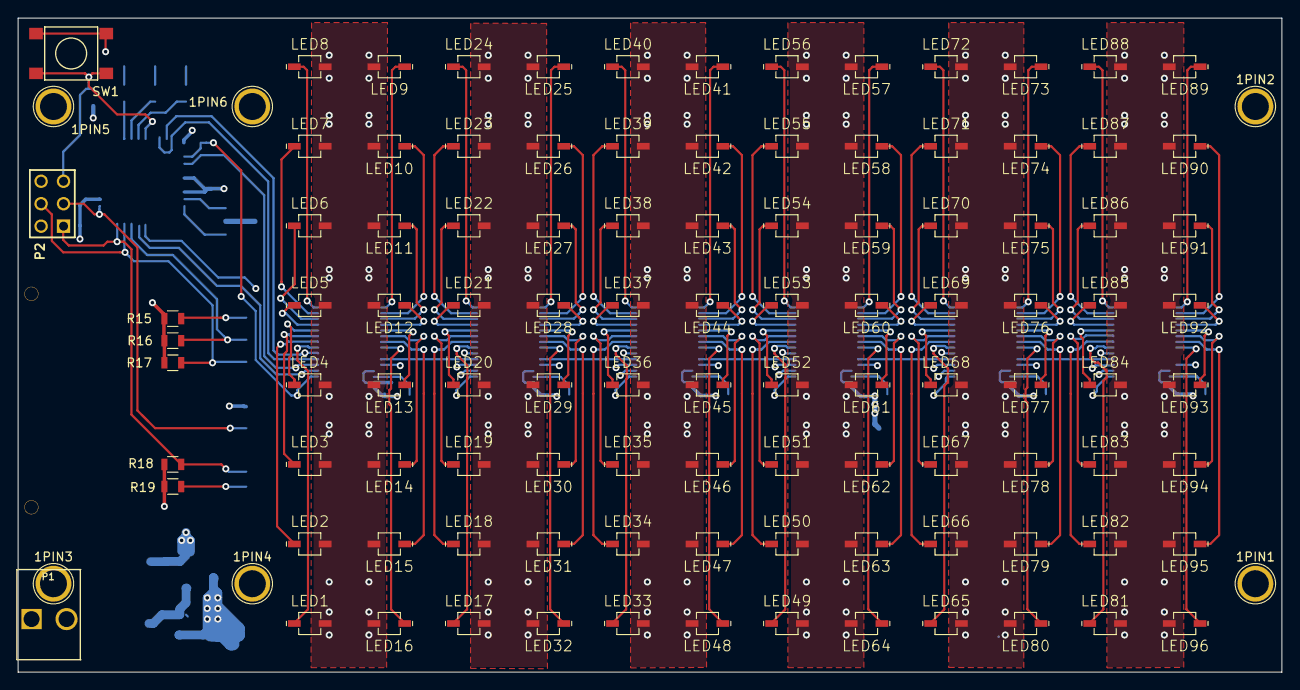
[picture p45: board lpa96.kicad_pcb from above]

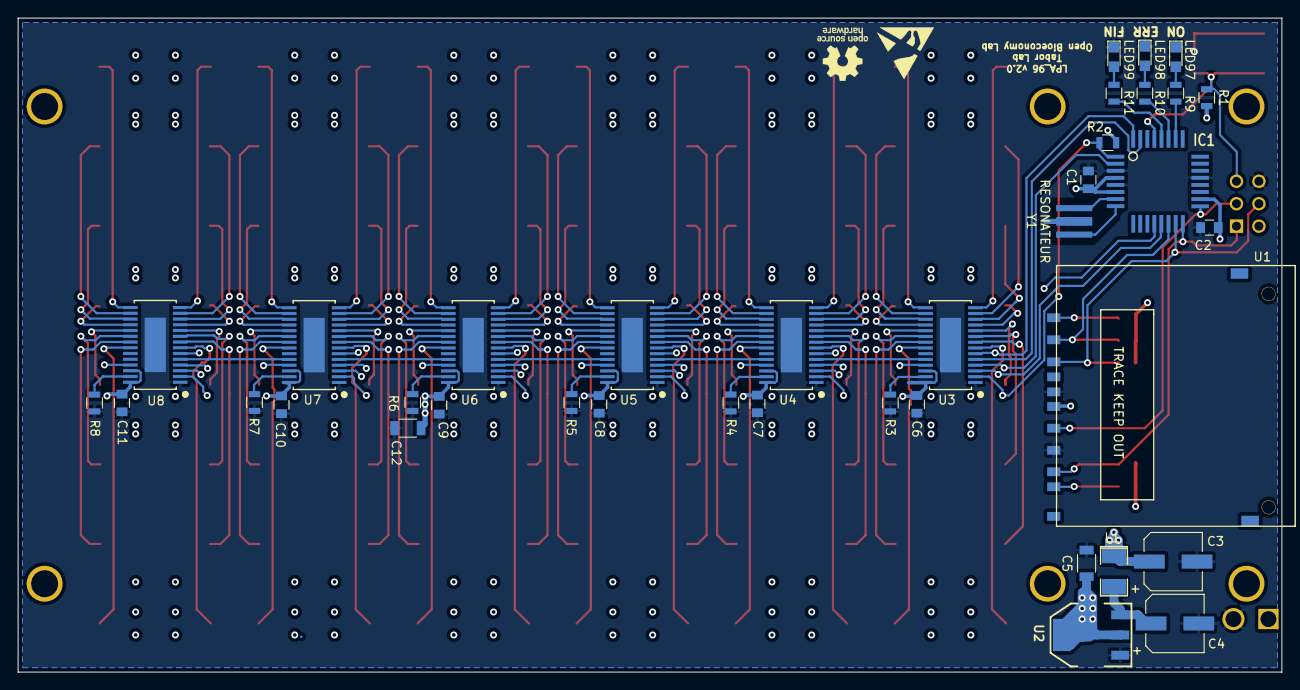
[picture p46: board lpa96.kicad_pcb from below]

Board: 4 copper layers, 143.0 x 74.0 mm, 147 parts (37 on the bottom side), 132 nets.

Other parts of the board:
1PIN1, 1PIN2, 1PIN3, 1PIN4, 1PIN5, 1PIN6: P***; 1pin
