J-E-J-S/LPA-hardware/(commit log)

2020-01-29 3d files clean
    [Assembled v1.stl, Base_96.f3d, Base_96.stl, Exploded Assembly v1.stl, LEDSpacer_Gasket.dxf, LEDSpacer_Gasket.f3d, LED_Spacer_96.f3d, LED_Spacer_96.stl]
2020-01-30 new assembly
    [Assembled_v1.f3z, Exploded_Assembly_v1.f3z, LPA96_Assembled.stl, LPA96_Exploded_Assembly.stl]
